randomlyiii/Project_CAN-BusEdgeCollector/demo-phase2/can总线故障恢复-从站续发+主从站心跳状态恢复.jpg

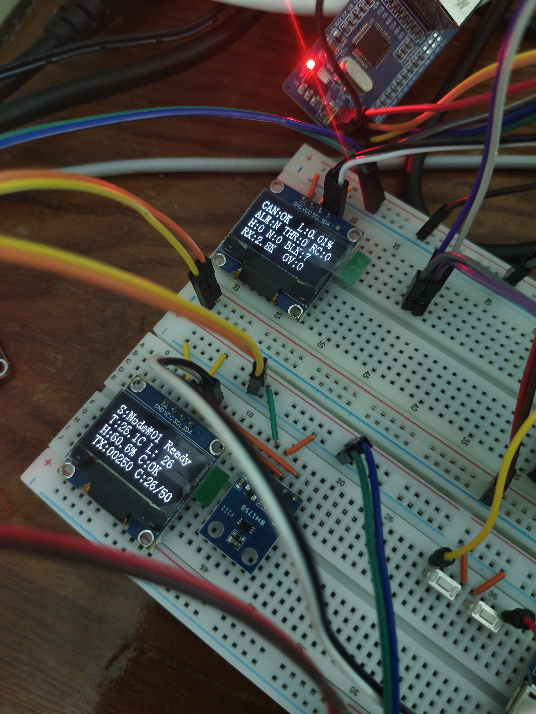
demo-phase2/can总线故障恢复-从站续发+主从站心跳状态恢复.jpg
