randomlyiii/Project_CAN-BusEdgeCollector/demo-phase1/从站故障报警接触-oled第四行显示OK.jpg

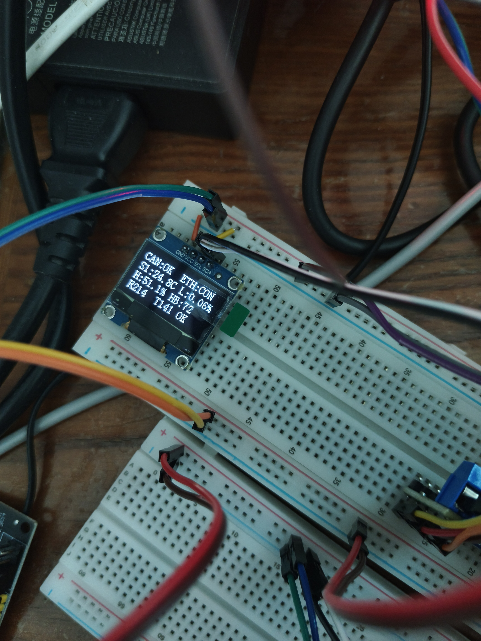
demo-phase1/从站故障报警接触-oled第四行显示OK.jpg
