randomlyiii/Project_CAN-BusEdgeCollector/排线设计/阶段三排线设计.md

# 阶段三（最终阶段）排线设计

> 架构变更：从站由**单硬件配置**升级为**单代码仓双变体**架构 —— 修改 `Config/slave_config.h` 一行宏即可在两种从站硬件之间切换，无需改动任何源码。
>
> 主站硬件与阶段一/二完全相同，无任何变更。

---

## 一、双从站变体总览

| 固件变体 | 配置宏 | 传感器组合 | 面包板 | 用途 |
|---|---|---|---|---|
| **从站 1** | `SLAVE_NODE_01` | DHT11（温湿度）+ BH1750（光照） | 面包板 #2 | 环境监测节点 |
| **从站 2** | `SLAVE_NODE_02` | LM393（光敏 DO/AO）+ 预留通道 CH1 | 面包板 #2 | 光敏监测 + 扩展占位 |

> **切换方式**：编辑 `Config/slave_config.h` 第 23 行，将 `SLAVE_NODE_VARIANT` 改为 `SLAVE_NODE_01` 或 `SLAVE_NODE_02`，重新编译即可。同一块 STM32 板子，换传感器 + 换宏 = 换身份。

---

## 二、系统整体接线拓扑

```
                    PC (上位机)
              Modbus TCP / ST-Link
                        │
                   ┌────┴────┐
                   │ 以太网   │ ST-Link
                   │ (RJ45)   │ (SWD)
                   │          │
┌──────────────────┴──────────┴───────────────┐
│             主站 (面包板 #1)                  │
│  ┌───────────────────────────────────────┐   │
│  │ STM32F103C8T6        W5500 以太网     │   │
│  │ OLED(0x78)           TJA1050 CAN      │   │
│  │ [SWD 4P排针]                          │   │
│  └───────────────────────────────────────┘   │
└──────────────────────┬──────────────────────┘
                        │ CAN_H / CAN_L / GND (杜邦线)
┌───────────────────────┴──────────────────────┐
│             从站 (面包板 #2)                   │
│                                               │
│  ┌─ 变体 A: Node#01 (SLAVE_NODE_01) ──────┐  │
│  │ STM32  DHT11(PB11)  BH1750(PB8/PB9)   │  │
│  │ OLED(PB8/PB9) ← 与BH1750共享I2C!       │  │
│  │ KEY1(PA0)  KEY2(PA1)  TJA1050 CAN     │  │
│  └────────────────────────────────────────┘  │
│                   或                          │
│  ┌─ 变体 B: Node#02 (SLAVE_NODE_02) ──────┐  │
│  │ STM32  LM393(PB0/PB1)  OLED(PB8/PB9)   │  │
│  │ DHT11(PB11)  KEY1(PA0)  KEY2(PA1)      │  │
│  │ TJA1050 CAN   预留 CH1 (软件占位)       │  │
│  └────────────────────────────────────────┘  │
│                                               │
│  [SWD 4P排针]                                 │
└───────────────────────────────────────────────┘
```

---

## 三、主站 (Master) 接线

> **与阶段一/二完全一致，无任何变更。** 主站固件也未修改。

### 3.1 引脚分配表

| STM32引脚 | 连接目标 | 说明 |
|---|---|---|
| PC15 | W5500 RST | 以太网复位 |
| PA4 | W5500 SCS | SPI 片选 |
| PA5 | W5500 SCLK | SPI 时钟 |
| PA6 | W5500 MISO | SPI 主入从出 |
| PA7 | W5500 MOSI | SPI 主出从入 |
| PA11 | TJA1050 RXD | CAN RX |
| PA12 | TJA1050 TXD | CAN TX |
| PB8 | OLED SCL | 软件 I2C 时钟 |
| PB9 | OLED SDA | 软件 I2C 数据 |

### 3.2 OLED

```
OLED (0.96寸, I2C, 4pin)
  GND → GND
  VCC → 3.3V
  SCL → PB8
  SDA → PB9
```

### 3.3 TJA1050 CAN 收发器

```
TJA1050 模块
  VCC  → 5V      (板子5V排针或外接电源)
  GND  → GND
  TXD  → PA12
  RXD  → PA11
  CANH → CAN_H 总线 (杜邦线→从站)
  CANL → CAN_L 总线 (杜邦线→从站)
```

### 3.4 W5500 以太网模块

```
W5500 模块
  GND  → GND   ← 模块有两个GND引脚，都要接地！
  GND  → GND   ← (第2个GND)
  3.3V → 3.3V  ← 外接独立3.3V，不要从STM32 3.3V排针取电
  SCLK → PA5
  MISO → PA6
  MOSI → PA7
  SCS  → PA4
  RST  → PC15
  INT  → 不接 (轮询模式)
  RJ45 → 网线 → PC
```

### 3.5 ST-Link

```
ST-Link           蓝 Pill SWD 排针
  SWDIO  →    SWDIO
  SWCLK  →    SWCLK
  GND    →    GND
  3.3V   →    不接！(板子USB供电，接3.3V会导致电源对顶)
```

---

## 四、从站变体 A — Node#01（DHT11 + BH1750）

> **配置宏**：`slave_config.h` → `SLAVE_NODE_VARIANT   SLAVE_NODE_01`
>
> **节点身份**：CAN ID=0x01, OLED 显示 "Node#01"

### 4.1 引脚分配表

| STM32引脚 | 连接目标 | 功能 | 备注 |
|---|---|---|---|
| PA0 | KEY1（故障上报） | GPIO 输入，内部上拉 | — |
| PA1 | KEY2（故障恢复） | GPIO 输入，内部上拉 | — |
| PA11 | TJA1050 RXD | CAN RX | — |
| PA12 | TJA1050 TXD | CAN TX | — |
| PB8 | OLED SCL + **BH1750 SCL** | **共享 I2C 时钟** | ★ 一总线两设备 |
| PB9 | OLED SDA + **BH1750 SDA** | **共享 I2C 数据** | ★ 一总线两设备 |
| PB11 | DHT11 DATA | 单总线 | — |

### 4.2 BH1750 光照传感器 ★ 重新引入

> BH1750 在阶段一曾规划但未实现，阶段二被 LM393 替代，最终阶段作为从站 1 的标准传感器重新引入。

```
BH1750 模块 (5pin)
  VCC  → 3.3V
  GND  → GND
  SCL  → PB8  ← 与 OLED SCL 共用！
  SDA  → PB9  ← 与 OLED SDA 共用！
  ADDR → GND  (地址引脚接地 → 7-bit 地址 0x23)
```

#### ⚠️ I2C 总线共享注意事项

BH1750 与 OLED **共用 PB8/PB9 I2C 总线**，两者通过不同设备地址区分：

| 设备 | I2C 地址 | 说明 |
|---|---|---|
| OLED | 0x78 (7-bit) | 写地址 0x78 |
| BH1750 | 0x23 (7-bit) | 写地址 0x46，读地址 0x47 |

> **软件 I2C 驱动**（`bh150.c/h`）使用 GPIO 模拟 I2C 时序（非 STM32 硬件 I2C 外设），因此不存在总线仲裁冲突。但两设备**不可在同一时刻被不同任务访问** —— 本项目设计中 BH1750 读取在 `vTask_Sensor`（优先级 3），OLED 刷新在 `vTask_Housekeep`（优先级 0），FreeRTOS 抢占式调度自然串行化访问。
>
> **如果将来传感器采集频率提高或驱动改为 DMA 模式，需加互斥锁保护 PB8/PB9。**

### 4.3 DHT11 温湿度

```
DHT11 (3pin)
  VCC  → 3.3V
  DATA → PB11 (需 4.7kΩ 上拉，模块已内置则免)
  GND  → GND
```

### 4.4 按键

```
KEY1: 一端→PA0, 另一端→GND
KEY2: 一端→PA1, 另一端→GND
(PA0/PA1 内部上拉，按下=低电平)
```

### 4.5 TJA1050 CAN 收发器

```
TJA1050 模块
  VCC  → 5V
  GND  → GND
  TXD  → PA12
  RXD  → PA11
  CANH → CAN_H 总线
  CANL → CAN_L 总线
```

### 4.6 ST-Link

```
ST-Link           蓝 Pill SWD 排针
  SWDIO  →    SWDIO
  SWCLK  →    SWCLK
  GND    →    GND
  3.3V   →    不接！
```

### 4.7 OLED 显示效果（Node#01）

```
┌──────────────────┐
│S:Node#01 Ready   │  ← Line 1: 节点身份 + 全局状态
│T:25.3C H:62.1%   │  ← Line 2: DHT11 温湿度 (SENSOR_TYPE_DHT11)
│Lux: 610          │  ← Line 3: BH1750 光照 (SENSOR_TYPE_BH1750)
│TX:00036 C:00/50  │  ← Line 4: CAN TX 计数 + 缓存占用
└──────────────────┘
```

### 4.8 从站 1 引脚总览

```
         ┌──────────────────────────┐
         │     STM32F103C8T6        │
         │                          │
  PB11 ←─→┤ DHT11 DATA             │
  PB8  ──→┤ OLED SCL + BH1750 SCL  │  ← 共享 I2C
  PB9  ←─→┤ OLED SDA + BH1750 SDA  │  ← 共享 I2C
  PA0  ←──┤ KEY1                   │
  PA1  ←──┤ KEY2                   │
  PA11 ←──┤ TJA1050 RXD            │
  PA12 ──→┤ TJA1050 TXD            │
         │                          │
         │  PA9  → USART1 TX (调试) │
         │  PA10 ← USART1 RX (调试) │
         └──────────────────────────┘
```

---

## 五、从站变体 B — Node#02（LM393 + 预留通道）

> **配置宏**：`slave_config.h` → `SLAVE_NODE_VARIANT   SLAVE_NODE_02`
>
> **节点身份**：CAN ID=0x02, CAN ID offset=0x10, OLED 显示 "Node#02"

### 5.1 引脚分配表

| STM32引脚 | 连接目标 | 功能 | 备注 |
|---|---|---|---|
| PA0 | KEY1（故障上报） | GPIO 输入，内部上拉 | — |
| PA1 | KEY2（故障恢复） | GPIO 输入，内部上拉 | — |
| PA11 | TJA1050 RXD | CAN RX | — |
| PA12 | TJA1050 TXD | CAN TX | — |
| PB0 | **LM393 DO** | GPIO 输入（数字亮/暗） | ★ |
| PB1 | **LM393 AO** | ADC1_IN9（模拟光照值） | ★ |
| PB8 | OLED SCL | 软件 I2C 时钟 | — |
| PB9 | OLED SDA | 软件 I2C 数据 | — |
| PB11 | DHT11 DATA | 单总线 | 保留接线，固件不编译 |

> **DHT11 保留接线**：虽然 Node#02 固件中 `slave_has_dht11=0`（DHT11 驱动不参与编译），但硬件保留 PB11→DHT11 接线，方便将来切换回 Node#01 验证而无须重新接线。

### 5.2 光敏电阻模块（LM393）

常见 4pin 光敏电阻模块，采用 **LM393 双路比较器**，板载光敏电阻（GL55系列）+ 可调电位器：

```
光敏模块 (4pin)
  VCC → 3.3V
  GND → GND
  DO  → PB0   ← 数字输出（超过阈值=LOW, 低于=HIGH，电位器可调）
  AO  → PB1   ← 模拟输出（0~3.3V，光越强电压越高）
```

#### 模块工作原理

```
         VCC (3.3V)
           │
          ┌┴┐
          │ │  光敏电阻 (GL55: 亮=5~10kΩ, 暗=0.5~1MΩ)
          │ │
          └┬┘
           ├──→ AO (分压点，光越强→阻值越小→电压越高)
           │
          ┌┴┐
          │ │  固定电阻 (10kΩ)
          │ │
          └┬┘
           │
          GND

  AO ──→ LM393 同相输入(+)
         反相输入(-) ← 电位器分压 (阈值电压)
         LM393 输出 → DO (开漏，需上拉)
```

- **光强 ↑** → 光敏电阻值 ↓ → AO 电压 ↑ → ADC 读值 ↑
- **AO 电压 > 阈值** → DO = LOW (亮灯)，反之 DO = HIGH (暗灯)
- DO 为 **开漏输出**，PB0 配置为 **内部上拉（IPU）**，无需外接电阻

#### 电位器调节

| 方向 | 效果 |
|---|---|
| 顺时针拧 | 阈值电压升高 → DO 更难触发 LOW → 需要更大光强 |
| 逆时针拧 | 阈值电压降低 → DO 更容易触发 LOW → 较小光强即触发 |

> 调试建议：在正常室内光照下，缓慢逆时针拧电位器直到 DO LED 刚好熄灭，此时为临界阈值。再逆时针拧 1/8 圈，确保正常光照下 DO=LOW（亮）。

#### 驱动 API（lm393.c / lm393.h）

```c
void     Lm393_Init(void);        // 初始化 PB0(IPU) + PB1(AIN) + ADC1
uint8_t  Lm393_ReadDigital(void); // 读 DO → 0=亮, 1=暗
uint16_t Lm393_ReadAnalog(void);  // 读 AO → ADC 原始值 0~4095
```

### 5.3 预留通道 CH1

Node#02 包含一个**软件层面的预留通道**，目前仅占位：

| 占位项 | 内容 | 说明 |
|---|---|---|
| 传感器表条目 | `sensor_t { .name="CH1", .init_fn=NULL, .read_fn=NULL }` | 占位，不执行任何驱动 |
| CAN 功能码 | `CAN_FUNC_RESERVED (0x07)` | 预留 CAN 通讯点位 |
| sensor_data_t | `reserved.ch1 (uint16_t)` | 预留 2 字节数据字段 |
| OLED 行 | `CH1:----` | 占位显示行 |

后续扩展步骤（接入 4-20mA / 开关量 / 继电器等新传感器）：
1. 编写传感器驱动（`my_sensor.h/c`）
2. 在 `sensor_manager.c` 中编写适配器函数
3. 替换 `#if slave_has_reserved` 代码块中 `NULL` 为适配器函数指针
4. 更新 `main.c` OLED 渲染 `case SENSOR_TYPE_RESERVED` 为实际数据显示
5. **无需修改任何任务代码或 CAN 通信逻辑**

### 5.4 按键（同 Node#01）

```
KEY1: 一端→PA0, 另一端→GND
KEY2: 一端→PA1, 另一端→GND
```

### 5.5 OLED 显示效果（Node#02）

```
┌──────────────────┐
│S:Node#02 Ready   │  ← Line 1: 节点身份 + 全局状态
│Lm DO:BR A:1234   │  ← Line 2: LM393 数字+模拟 (SENSOR_TYPE_LM393_AO)
│CH1:----          │  ← Line 3: 预留通道占位 (SENSOR_TYPE_RESERVED)
│TX:00042 C:00/50  │  ← Line 4: CAN TX 计数 + 缓存占用
└──────────────────┘
```

> DO 显示：`BR` = Bright（亮，低于阈值），`DK` = Dark（暗，高于阈值）

### 5.6 从站 2 引脚总览

```
         ┌──────────────────────────┐
         │     STM32F103C8T6        │
         │                          │
  PB0  ←──┤ LM393 DO               │
  PB1  ←──┤ LM393 AO (ADC1_IN9)    │
  PB8  ──→┤ OLED SCL               │
  PB9  ←─→┤ OLED SDA               │
  PB11 ←─→┤ DHT11 DATA (保留接线)   │  ← 固件不编译，硬件不动
  PA0  ←──┤ KEY1                   │
  PA1  ←──┤ KEY2                   │
  PA11 ←──┤ TJA1050 RXD            │
  PA12 ──→┤ TJA1050 TXD            │
         │                          │
         │  PA9  → USART1 TX (调试) │
         │  PA10 ← USART1 RX (调试) │
         └──────────────────────────┘
```

---

## 六、双变体切换对照

| 维度 | Node#01 (SLAVE_NODE_01) | Node#02 (SLAVE_NODE_02) |
|---|---|---|
| **切换方式** | `#define SLAVE_NODE_VARIANT SLAVE_NODE_01` | `#define SLAVE_NODE_VARIANT SLAVE_NODE_02` |
| **CAN 节点 ID** | 0x01 | 0x02 |
| **CAN ID offset** | 0x00 | 0x10 |
| **传感器** | DHT11 + BH1750 | LM393 + 预留 CH1 |
| **传感器个数** | 2（OLED 行 2/3 均有数据） | 2（一行 LM393 + 一行占位） |
| **I2C 设备** | OLED(0x78) + BH1750(0x23) 共享 PB8/PB9 | OLED(0x78) 独占 PB8/PB9 |
| **ADC 使用** | 无 | ADC1_IN9 (PB1) |
| **唯一 GPIO** | 仅 PB11 (DHT11) | PB0/PB1 (LM393) |
| **编译驱动** | dht11.c + bh150.c | lm393.c |
| **排除驱动** | lm393.c | dht11.c + bh150.c |

---

## 七、CAN 总线（不变）

```
主站 CAN_H ──── 杜邦线 ──── 从站 CAN_H
主站 CAN_L ──── 杜邦线 ──── 从站 CAN_L
主站 GND   ──── 杜邦线 ──── 从站 GND   (共地必须！)
```

- 桌面短距离（<30cm）：不接终端电阻
- 长距离：需 120Ω 1/4W 终端电阻
- CAN 差分总线也必须共地（TJA1050 共模电压以本地 GND 为参考）

---

## 八、供电（不变）

```
外接 5V/3.3V 电源
  5V  → 主站 5V 排针  → TJA1050 VCC
       → 从站 5V 排针  → TJA1050 VCC
  3.3V → 主站 3.3V 排针 → OLED / W5500
       → 从站 3.3V 排针 → OLED / DHT11 / BH1750或LM393
  GND  → 主站 GND / 从站 GND
```

或每块蓝 Pill 单独 USB 供电（桌面调试推荐）。

---

## 九、面包板布局

```
面包板#1 (主站)                   面包板#2 (从站)
┌──────────────────────┐        ┌──────────────────────────────┐
│ STM32       W5500    │        │ STM32       DHT11           │
│ OLED        TJA1050  │        │ OLED        [BH1750或LM393] │  ← 变体切换
│ [SWD排针]            │        │ KEY1/2      TJA1050         │
│                      │        │ [SWD排针]                    │
└──────────────────────┘        └──────────────────────────────┘

面包板#3 (备用 — 用于 Node#02 同时保留 Node#01 接线时)
```

> **变体切换物理操作**：
> - Node#01 → Node#02：拔掉 BH1750 模块（PB8/PB9），插上 LM393 模块（PB0/PB1/3.3V/GND），改 `slave_config.h` 宏，重新编译烧录
> - Node#02 → Node#01：拔掉 LM393 模块，插上 BH1750 模块，改宏，重新编译烧录
>
> PB11→DHT11 接线两变体通用，无需插拔。

---

## 十、检查清单

### 10.1 通用检查项（两变体共用）

| # | 检查项 | ✓ |
|---|---|---|
| 1 | 主站 OLED：PB8→SCL, PB9→SDA, VCC→3.3V, GND→GND | ☐ |
| 2 | 主站 TJA1050：PA11→RXD, PA12→TXD, VCC→5V, GND→GND | ☐ |
| 3 | 主站 W5500：PA5→SCLK, PA6→MISO, PA7→MOSI, PA4→SCS, PC15→RST, **双GND都接地**, 外接3.3V供电 | ☐ |
| 4 | 主站 ST-Link：SWDIO/SWCLK/GND（不接3.3V） | ☐ |
| 5 | 从站 OLED：PB8→SCL, PB9→SDA, VCC→3.3V, GND→GND | ☐ |
| 6 | 从站 TJA1050：PA11→RXD, PA12→TXD, VCC→5V, GND→GND | ☐ |
| 7 | 从站 DHT11：PB11→DATA, VCC→3.3V, GND→GND | ☐ |
| 8 | 从站按键：PA0→KEY1→GND, PA1→KEY2→GND | ☐ |
| 9 | 从站 ST-Link：SWDIO/SWCLK/GND（不接3.3V） | ☐ |
| 10 | CAN 总线：CAN_H 互连, CAN_L 互连, GND 互连 | ☐ |
| 11 | 供电：5V 给 TJA1050, 3.3V 给 OLED/W5500/DHT11/传感器 | ☐ |
| 12 | 网线：主站 W5500 RJ45 → PC | ☐ |
| 13 | 配置宏：`slave_config.h` 中 `SLAVE_NODE_VARIANT` 与实际接线匹配 | ☐ |

### 10.2 Node#01 专项检查项

| # | 检查项 | ✓ |
|---|---|---|
| N1-1 | BH1750 模块：VCC→3.3V, GND→GND, SCL→PB8, SDA→PB9, ADDR→GND | ☐ |
| N1-2 | BH1750 与 OLED 共用 PB8/PB9，确认无短路 | ☐ |
| N1-3 | OLED 显示验证：Line2="T:xx.xC H:xx.x%", Line3="Lux:xxxx" | ☐ |
| N1-4 | 手遮 BH1750 → Lux 值下降；手电筒照射 → Lux 值上升 | ☐ |
| N1-5 | 编译时 `slave_has_dht11=1`, `slave_has_bh1750=1`, `slave_has_lm393=0` | ☐ |

### 10.3 Node#02 专项检查项

| # | 检查项 | ✓ |
|---|---|---|
| N2-1 | LM393 模块：VCC→3.3V, GND→GND, DO→PB0, AO→PB1 | ☐ |
| N2-2 | LM393 与 OLED 独立走线，不共用 I2C 总线 | ☐ |
| N2-3 | 电位器调试：正常光照下 DO LED 刚好熄灭 → 临界阈值 | ☐ |
| N2-4 | OLED 显示验证：Line2="Lm DO:BR A:xxxx", Line3="CH1:----" | ☐ |
| N2-5 | 手遮光敏电阻 → Lm AO 值降、DO 变 DK；手电筒照射 → AO 值升、DO 变 BR | ☐ |
| N2-6 | 编译时 `slave_has_dht11=0`, `slave_has_lm393=1`, `slave_has_reserved=1` | ☐ |
| N2-7 | 预留通道占位正确：OLED 第三行显示 `CH1:----`，主站可收到 CAN_FUNC_RESERVED 帧 | ☐ |

---

## 十一、架构迁移对照

```
阶段一（裸机）                阶段二（FreeRTOS）              最终阶段（双变体）
──────────────────────────────────────────────────────────────────────────────
1个从站                     1个从站                        1套源码 → 2种从站
DHT11 单传感器              DHT11 + LM393                 Node#01: DHT11+BH1750
无 FreeRTOS                 FreeRTOS 4任务                 Node#02: LM393+预留
SLAVE_NODE_ID 硬编码        SLAVE_NODE_ID 硬编码           slave_node_id 配置宏驱动
CAN_SendTempHumi()          CAN_SendTempHumi/Light()      CAN_SendSensorData(type_id)
OLED 简单3行                OLED 4行 条件判断             OLED 4行 表驱动自适应
单文件 main.c               main.c + CAN_User.c            + Config/ + sensor_manager
传感器全局变量分散           传感器全局变量集中             传感器数据→sensor_t.last_data
```

---

## 十二、相关文档

| 文档 | 路径 | 说明 |
|---|---|---|
| 最终阶段设计 | `phase_md/最终阶段.md` | 架构升级完整设计文档 |
| README | `README.md` | 项目总体设计（CAN 协议 / 双FIFO / 采集分层） |
| 阶段一排线 | `排线设计/阶段一排线设计.md` | 主站引脚 / CAN / 供电基础 |
| 阶段二排线 | `排线设计/阶段二排线设计.md` | LM393 光敏模块详细说明 |
| LM393 驱动 | `CanEdgeGateWay_Slave/Hardware/lm393.c` | 光敏 DO/AO 驱动源码 |
| BH1750 驱动 | `CanEdgeGateWay_Slave/Hardware/bh150.c` | 光照传感器 I2C 驱动源码 |
| 传感器管理 | `CanEdgeGateWay_Slave/Hardware/sensor_manager.c` | 表驱动适配器层 |
| 配置入口 | `CanEdgeGateWay_Slave/Config/slave_config.h` | 变体切换宏 |
