randomlyiii/Project_CAN-BusEdgeCollector/CanEdgeGateWay_Slave/README.txt

1. 在./Config/slave config.h进行从站之间的烧录切换
2.在./Config/slave_node_0x.h改传感器报警阈值
