randomlyiii/Project_CAN-BusEdgeCollector/demo-phase3/readme.txt

项目设计要求功能均已开发实现；本次验收仅完成核心功能测试，全量边界验证待持续拷机完善。
