randomlyiii/Project_CAN-BusEdgeCollector/phase_md/阶段二遇到的问题及解决.md

# 阶段二遇到的问题及解决

> 时间段: 2026-07-24  
> 主题: FreeRTOS 内核编译/链接错误修复 + RAM 布局优化 + 阶段二-2 恢复 W5500/CAN 调试

---

## 问题一: TCB_t 缺少 ulNotifiedValue[] / ucNotifyState[] (30 errors)

**错误信息**:
```
FreeRTOS\src\tasks.c(405): error: #136: struct "tskTaskControlBlock" has no field "ulNotifiedValue"
FreeRTOS\src\tasks.c(406): error: #136: struct "tskTaskControlBlock" has no field "ucNotifyState"
... (共 30 个 error，遍布 tasks.c 405~1270 行)
```

**根因**:

`task.h` 中 TCB_t 有两个定义:
1. **顶部无守卫** (第39行): 简化版 TCB，只含 8 个字段，并设置了 `#define tskTCB_DEFINED`
2. **MPU 守卫内** (第192行): 完整 TCB，含通知/Mutex/统计字段，受 `#ifndef tskTCB_DEFINED` 保护

`tasks.c` 虽然正确定义了 `MPU_WRAPPERS_INCLUDED_FROM_API_FILE`，但顶部简化版先执行了 `#define tskTCB_DEFINED`，导致 `#ifndef tskTCB_DEFINED` 为假，完整 TCB 被跳过。通知字段 `ulNotifiedValue[]` 和 `ucNotifyState[]` 只存在于完整 TCB 中 (`configUSE_TASK_NOTIFICATIONS == 1`)，因此全部报错。

**修复** (task.h, Master + Slave):
1. 将顶部简化版 TCB + `#define tskTCB_DEFINED` 替换为前向声明: `typedef struct tskTaskControlBlock TCB_t;`
2. 移除 MPU 区域内的 `#ifndef tskTCB_DEFINED` / `#define tskTCB_DEFINED` / `#endif` 三重守卫
3. 结果: 外部代码只看到前向声明（只能声明指针），内核代码定义 MPU 宏后看到完整结构体

**涉及文件**:
- `CanEdgeGateWay_Master/FreeRTOS/inc/task.h`
- `CanEdgeGateWay_Slave/FreeRTOS/inc/task.h`

---

## 问题二: QueueDefinition 缺少 ucQueueTypeInternal (5 errors)

**错误信息**:
```
FreeRTOS\src\queue.c(113): error: #136: struct "QueueDefinition" has no field "ucQueueTypeInternal"
... (共 5 个 error，遍布 queue.c 113~1070 行)
```

**根因**:
`queue.h` 中 `QueueDefinition` 结构体缺少 `ucQueueTypeInternal` 字段。此字段用于区分普通队列/互斥锁/递归互斥锁/信号量——`queue.c` 在多处使用它判断队列类型。

**修复** (queue.h, Master + Slave):
在 `QueueDefinition` 末尾、`};` 之前添加:
```c
uint8_t ucQueueTypeInternal;
```

**涉及文件**:
- `CanEdgeGateWay_Master/FreeRTOS/inc/queue.h`
- `CanEdgeGateWay_Slave/FreeRTOS/inc/queue.h`

---

## 问题三: port.c 汇编符号未定义 (3 errors)

**错误信息**:
```
FreeRTOS\src\port.c(48): error: A1516E: Bad symbol 'pxCurrentTCB', not defined or external
FreeRTOS\src\port.c(68): error: A1516E: Bad symbol 'pxCurrentTCB', not defined or external
FreeRTOS\src\port.c(78): error: A1516E: Bad symbol 'vTaskSwitchContext', not defined or external
```

**根因**:
ARMCC v5 的 `__asm` 函数由 **armasm** 汇编器独立处理，不继承 C 级别的 `extern` 声明。即使用 C 写了 `extern TCB_t * volatile pxCurrentTCB;` 和 `extern void vTaskSwitchContext(void);`，汇编器仍然不知道这些符号。必须用 `IMPORT` 指令显式声明。

**修复** (port.c, Master + Slave):

`vPortSVCHandler` — 添加 IMPORT:
```asm
__asm void vPortSVCHandler(void)
{
    PRESERVE8
    IMPORT pxCurrentTCB          ← 新增
    ldr r3, =pxCurrentTCB
    ...
```

`xPortPendSVHandler` — 添加 IMPORT:
```asm
__asm void xPortPendSVHandler(void)
{
    PRESERVE8
    IMPORT pxCurrentTCB          ← 新增
    IMPORT vTaskSwitchContext    ← 新增
    mrs r0, psp
    ...
```

**涉及文件**:
- `CanEdgeGateWay_Master/FreeRTOS/src/port.c`
- `CanEdgeGateWay_Slave/FreeRTOS/src/port.c`

---

## 问题四: SysTick_Handler 重复定义 (1 error)

**错误信息**:
```
.\Objects\ceg_master.axf: Error: L6200E: Symbol SysTick_Handler multiply defined (by port.o and delay.o).
```

**根因**:
`FreeRTOSConfig.h` 中有宏 `#define xPortSysTickHandler SysTick_Handler`，把 `port.c` 的 `xPortSysTickHandler` 重命名为 `SysTick_Handler`。同时 `System/Delay.c` 也定义了 `void SysTick_Handler(void)`（作为向量表入口，桥接到 FreeRTOS）。两个 .o 都导出了 `SysTick_Handler`，链接冲突。

SVC 和 PendSV 直接用宏映射没问题（因为没有用户代码定义这些 handler），但 SysTick 的中转模式需要 Delay.c 持有向量表入口。

**修复** (FreeRTOSConfig.h, Master + Slave):
移除 `#define xPortSysTickHandler SysTick_Handler`，保留 SVC/PendSV 映射不变。

修复后的调用链:
```
向量表 → Delay.c:SysTick_Handler() → port.c:xPortSysTickHandler() → FreeRTOS tick
```

**涉及文件**:
- `CanEdgeGateWay_Master/User/FreeRTOSConfig.h`
- `CanEdgeGateWay_Slave/User/FreeRTOSConfig.h`

---

## 问题五: TCB_t 缺少 uxStackDepth (1 error)

**错误信息**:
```
FreeRTOS\src\tasks.c(1040): error: #136: struct "tskTaskControlBlock" has no field "uxStackDepth"
```

**根因**:
之前的"简化版"TCB 有 `configSTACK_DEPTH_TYPE uxStackDepth` 字段，但 MPU 守卫内的完整 TCB 漏掉了。`tasks.c` 的 `uxTaskGetStackHighWaterMark()` 使用此字段做边界检查。

**修复** (task.h, Master + Slave):
在 MPU TCB_t 的 `pcTaskName` 之后添加:
```c
configSTACK_DEPTH_TYPE  uxStackDepth;
```

> 注意: 标准 FreeRTOS 的 TCB_t 没有此字段——这是本项目添加的非标准字段。

---

## 问题六: 链接时 RAM 溢出 (20 errors)

**错误信息**:
```
.\Objects\ceg_master.axf: Error: L6406E: No space in execution regions with .ANY selector matching startup_stm32f10x_md.o(STACK).
.\Objects\ceg_master.axf: Error: L6406E: No space in execution regions with .ANY selector matching tasks.o(.bss).
... (共 20 个 error)
.\Objects\ceg_master.axf: Error: L6407E: Sections of aggregate size 0xa30 bytes could not fit into .ANY selector(s).
```

**根因**:
STM32F103C8T6 总共只有 **20KB RAM**。内存占用分析:

| 项目 | 修改前 | 占比 |
|---|---|---|
| MSP 栈 | 1KB | 5% |
| 系统堆 (libc) | 0.5KB | 2.5% |
| FreeRTOS 堆 (ucHeap[]) | **15KB** | **75%** |
| 固定占用合计 | 16.5KB | 82.5% |
| 剩余给 .data/.bss | 3.5KB | 17.5% |

实际 .data/.bss 需要 ~6.1KB (3.5KB + 溢出 2.6KB)，超过了剩余的 3.5KB。FreeRTOS 堆的 `ucHeap[]` 是静态数组，编译时计入 .bss，15KB 占掉了 75% 的 RAM。

**修复** (三处):

| 参数 | 修改前 | 修改后 | 释放 |
|---|---|---|---|
| `configTOTAL_HEAP_SIZE` | 15KB | **10KB** | 5KB |
| `Stack_Size` (MSP) | 1024B | **512B** | 512B |
| `Heap_Size` (libc) | 512B | **0** | 512B |
| **合计释放** | — | — | **6KB** |

其中 libc 堆归零是安全的——项目只使用 FreeRTOS 的 `pvPortMalloc`，不调用标准 `malloc()`。

**涉及文件**:
- `CanEdgeGateWay_Master/User/FreeRTOSConfig.h` (configTOTAL_HEAP_SIZE)
- `CanEdgeGateWay_Slave/User/FreeRTOSConfig.h` (configTOTAL_HEAP_SIZE)
- `CanEdgeGateWay_Master/Start/startup_stm32f10x_md.s` (Stack_Size, Heap_Size)

---

## 问题七: xTaskGetCurrentTaskHandle 未定义 (1 error)

**错误信息**:
```
.\Objects\ceg_master.axf: Error: L6218E: Undefined symbol xTaskGetCurrentTaskHandle (referred from tasks.o).
```

**根因**:
`task.h` 中声明了 `TaskHandle_t xTaskGetCurrentTaskHandle(void)`，`tasks.c` 中互斥锁代码调用了它（用于判断当前任务是否持有互斥锁），但 **从未实现**这个函数。

**修复** (tasks.c, Master + Slave):
在 `uxTaskGetNumberOfTasks()` 之后添加:
```c
TaskHandle_t xTaskGetCurrentTaskHandle(void)
{
    TaskHandle_t xReturn;
    taskENTER_CRITICAL();
    {
        xReturn = (TaskHandle_t)pxCurrentTCB;
    }
    taskEXIT_CRITICAL();
    return xReturn;
}
```

**涉及文件**:
- `CanEdgeGateWay_Master/FreeRTOS/src/tasks.c`
- `CanEdgeGateWay_Slave/FreeRTOS/src/tasks.c`

---

## 总结

| 问题编号 | 错误数 | 类型 | 涉及文件 | 根因类别 |
|---|---|---|---|---|
| 一 | 30 | 编译 | task.h | TCB_t 守卫宏逻辑错误 |
| 二 | 5 | 编译 | queue.h | 结构体缺少字段 |
| 三 | 3 | 编译 | port.c | ARMCC 汇编 IMPORT 缺失 |
| 四 | 1 | 链接 | FreeRTOSConfig.h | 宏重命名与显式定义冲突 |
| 五 | 1 | 编译 | task.h | MPU TCB 遗漏非标准字段 |
| 六 | 20 | 链接 | FreeRTOSConfig.h + startup | RAM 预算超限 |
| 七 | 1 | 链接 | tasks.c | 函数只声明未实现 |
| **合计** | **61** | — | **6 类文件** | — |

**修改文件清单** (共 11 个文件, Master + Slave 对称):

```
CanEdgeGateWay_Master/FreeRTOS/inc/task.h         ← 问题一、五
CanEdgeGateWay_Master/FreeRTOS/inc/queue.h        ← 问题二
CanEdgeGateWay_Master/FreeRTOS/src/port.c          ← 问题三
CanEdgeGateWay_Master/FreeRTOS/src/tasks.c         ← 问题七
CanEdgeGateWay_Master/User/FreeRTOSConfig.h        ← 问题四、六
CanEdgeGateWay_Master/Start/startup_stm32f10x_md.s ← 问题六
CanEdgeGateWay_Slave/...(同上 6 个文件)              ← 对称修复
```

**获得的经验**:
1. 不标准的 FreeRTOS 内核文件需要从标准版分叉时，要理解每个 `#ifdef` 守卫的意图
2. ARMCC v5 的 `__asm` 和 GCC inline asm 机制完全不同，移植时 `IMPORT`/`EXPORT` 是关键
3. STM32F103C8 的 20KB RAM 很紧张，`configTOTAL_HEAP_SIZE` 是第一个要审查的配置
4. 链接错误比编译错误更难排查——用"RAM 预算表"逐项检查是最快的方法

---

## 问题八: MSP 栈溢出 → 卡 "M: Starting..."（IWDG 循环复位）

**时间段**: 2026-07-24 下午（阶段二-2：恢复 W5500/CAN）

**症状**:
```
OLED 显示:
  Line 1: M: Starting...
  Line 2: FreeRTOS v10.4
  （此后无变化，约 1-2 秒后系统复位，循环）
```

**根因**:
MSP 栈（主栈，Main Stack Pointer）仅 512 字节（`0x200`）。`CAN_User_Init()` + `W5500_Init()` 的调用链深度超过 512B 时，MSP 溢出向下踩踏 `.bss` 段中的 `ucHeap[]`（FreeRTOS 堆数组），导致：
1. `pvPortMalloc()` 返回损坏的内存块
2. `xTaskCreate()` 创建的 TCB 或栈被破坏
3. 调度器启动后首个被破坏的任务运行 → 硬 fault 或死循环
4. IWDG 无法喂狗 → 1 秒后系统复位 → 重复循环

**为什么之前 3 调试任务能跑**：
调试版不调 `CAN_User_Init` 和 `W5500_Init`，MSP 调用链浅，512B 勉强够。

**修复** (`startup_stm32f10x_md.s`, Master + Slave):
```asm
Stack_Size      EQU     0x00000400    ; 512B → 1024B
```

**涉及文件**:
- `CanEdgeGateWay_Master/Start/startup_stm32f10x_md.s`
- `CanEdgeGateWay_Slave/Start/startup_stm32f10x_md.s`

**教训**:
- MSP 栈溢出是最隐蔽的故障模式之一——它踩的是 `ucHeap[]`，不是栈自身，所以不会触发 HardFault，而是表现为随机任务崩溃
- 添加重量级初始化函数（CAN_Init、SPI 外设探测）前必须评估 MSP 需求
- 文档 §10.3 已提前警告 512B 不够，恢复 W5500/CAN 后果然触发

---

## 问题九: CAN_User_Init 中断使能顺序错误

**时间段**: 2026-07-24 下午

**症状**:
潜在——CAN 错误 ISR 在信号量尚未创建时触发 → `xSemaphoreGiveFromISR(NULL)` → `configASSERT` → 死循环。

**根因**:
`CAN_User_Init()` 中中断使能和信号量创建顺序反了：

```c
// 错误顺序:
CAN_ITConfig(CAN1, CAN_IT_ERR, ENABLE);   // ← 先使能中断
CAN_NVIC_Init();                             // ← 在 NVIC 层也使能
g_can_monitor_sem = xSemaphoreCreateBinary(); // ← 后创建信号量
```

若 CAN 外设在 init 后立即因总线噪声/ACK 错误触发 `CAN1_SCE_IRQHandler`，此时 `g_can_monitor_sem` 为 NULL，`xSemaphoreGiveFromISR(NULL)` 触发 `configASSERT` → 关中断 + 死循环。

**修复** (CAN_User.c, Master + Slave):
```c
// 正确顺序: 先创建所有内核对象
g_can_rx_sem         = xSemaphoreCreateBinary();
g_can_fifo_not_empty = xSemaphoreCreateBinary();
g_can_monitor_sem    = xSemaphoreCreateBinary();
FIFO_Init();             // 创建 mutex

// 再使能中断
CAN_ITConfig(CAN1, CAN_IT_FMP0, ENABLE);
CAN_ITConfig(CAN1, CAN_IT_ERR, ENABLE);
CAN_ITConfig(CAN1, CAN_IT_BOF, ENABLE);
CAN_NVIC_Init();
```

**涉及文件**:
- `CanEdgeGateWay_Master/Hardware/CAN_User.c`
- `CanEdgeGateWay_Slave/Hardware/CAN_User.c`

---

## 问题十: Task_W5500 临界区阻塞 SysTick → 任务饿死

**时间段**: 2026-07-24 下午

**症状**:
`Task_W5500` 用 `taskENTER_CRITICAL()` 包裹 `W5500_TCPServer_Run()`，导致 SysTick 中断被屏蔽，Tick 计数不增长，其他任务因 `vTaskDelayUntil` 无法到期而饿死。IWDG 在 1 秒后复位系统。

**根因**:
- `taskENTER_CRITICAL()` 设置 `BASEPRI = 0x50`
- SysTick 优先级 15，NVIC 寄存器值 `0xF0`，满足 `0xF0 ≥ 0x50` → **被屏蔽**
- 同时 PendSV（优先级 15 = `0xF0`）也被屏蔽 → 无法上下文切换
- `W5500_TCPServer_Run` 内部 `SocketCmd` 超时循环用 `Delay_us(DWT)` 消耗真实时间（200ms/次），但不产生任何 Tick
- 退出临界区后 Tick 追赶式增长，但 Housekeep 的 `vTaskDelayUntil(1000ms)` 实际上隔了数秒才到期
- 期间 IWDG 已超时复位

**修复**：
W5500 独占 SPI1（OLED 是软件 I2C，CAN 是 bxCAN），无需临界区保护。移除 `taskENTER_CRITICAL/taskEXIT_CRITICAL`：

```c
for (;;) {
    W5500_TCPServer_Run();    // 无临界区
    ModbusTCP_Process();      // 无临界区
    vTaskDelay(pdMS_TO_TICKS(5));
}
```

**涉及文件**:
- `CanEdgeGateWay_Master/User/main.c`

**经验**:
- BASEPRI 不是 PRIMASK！`taskENTER_CRITICAL()` 只屏蔽优先级 ≥ 阈值的中断。SysTick 和 PendSV 通常设为最低优先级（15），恰好被 BASEPRI 挡住。
- 一个任务在临界区里吃 DWT 延时 = 整个系统停摆（比 `vTaskDelay` 更恶劣，因为 Tick 不前进）。
- 临界区的正确使用场景：多个任务共享同一外设（如 SPI Flash）。单任务独占的外设不需要临界区。

---

## 问题十一: Task_Housekeep 栈不足

**时间段**: 2026-07-24 下午

**症状**:
`Task_Housekeep`（栈 256 words）调用 `OLED_UpdateDisplay()` 时栈溢出，破坏堆中相邻的其他任务栈 → 系统异常。

**根因**:
`OLED_UpdateDisplay()` 内部多次调用 `sprintf()`（ARMCC 标准库实现，栈消耗极大）。文档 §11 已明确要求：**调用 sprintf 的任务至少分配 384 words**。

**修复** (main.c):
```c
#define STACK_HOUSEKEEP     384    // 256 → 384
```

**涉及文件**:
- `CanEdgeGateWay_Master/User/main.c`

---

## 总结（第二阶段完整版）

| 问题编号 | 错误数 | 类型 | 涉及文件 | 根因类别 |
|---|---|---|---|---|
| 一 | 30 | 编译 | task.h | TCB_t 守卫宏逻辑错误 |
| 二 | 5 | 编译 | queue.h | 结构体缺少字段 |
| 三 | 3 | 编译 | port.c | ARMCC 汇编 IMPORT 缺失 |
| 四 | 1 | 链接 | FreeRTOSConfig.h | 宏重命名与显式定义冲突 |
| 五 | 1 | 编译 | task.h | MPU TCB 遗漏非标准字段 |
| 六 | 20 | 链接 | FreeRTOSConfig.h + startup | RAM 预算超限 |
| 七 | 1 | 链接 | tasks.c | 函数只声明未实现 |
| **八** | **运行时** | **启动** | **startup_stm32f10x_md.s** | **MSP 栈溢出踩 ucHeap[]** |
| **九** | **运行时** | **中断** | **CAN_User.c** | **ISR 信号量竞态** |
| **十** | **运行时** | **调度** | **main.c** | **临界区锁死 SysTick** |
| **十一** | **运行时** | **栈** | **main.c** | **Task_Housekeep 栈不足** |

**阶段二最终修改文件清单**（共 15 个文件）：

```
编译/链接修复（问题一~七，11 文件）:
  FreeRTOS/inc/task.h
  FreeRTOS/inc/queue.h
  FreeRTOS/src/port.c
  FreeRTOS/src/tasks.c
  User/FreeRTOSConfig.h
  Start/startup_stm32f10x_md.s
  （Master + Slave 各 6 个 = 12 个实例文件，其中 startup 共用改动）

运行期修复（问题八~十一，本日新增）:
  Start/startup_stm32f10x_md.s             ← MSP 512→1024
  Hardware/CAN_User.c                      ← 中断使能顺序
  User/main.c                              ← 移除 W5500 临界区 + Housekeep 栈增大
  （Master + Slave 各 1 个 startup + 1 个 CAN_User = 4 文件）
```

---

## 问题十二: CAN_ProcessFrame 在任务上下文调用 xSemaphoreGiveFromISR

**时间段**: 2026-07-24 傍晚（阶段二-2 深度排查）

**症状**:
调度器启动后系统卡 "M: Starting..."，无 HardFault、无 STACK OVERFLOW 提示。所有 init 通过，xTaskCreate 全部成功，但调度器启动后立即挂死。

**根因**:
`CAN_ProcessFrame()` 由 `Task_CAN_Rx`（任务上下文，prio 5）调用，但内部使用了 `xSemaphoreGiveFromISR()`：

```c
// CAN_User.c — CAN_ProcessFrame (called from Task_CAN_Rx)
static BaseType_t tx_woken = pdFALSE;
xSemaphoreGiveFromISR(g_can_fifo_not_empty, &tx_woken);  // ← 致命错误
xSemaphoreGive(g_can_fifo_not_empty);                     // ← 还重复给了两次
```

`xSemaphoreGiveFromISR` 内部调用 `xQueueGiveFromISR`，该函数会:
1. 调用 `xTaskRemoveFromEventList()` — 操作调度器的 `xPendingReadyList`
2. 修改就绪优先级位图 `uxReadyPriorities`
3. 这些操作必须与 `xTaskIncrementTick()`（在 SysTick 中运行）互斥

在 ISR 上下文中，互斥由中断优先级保证（BASEPRI 挡不住优先级 0-4 的 ISR，但 FromISR 函数内部有 `portASSERT_IF_INTERRUPT_PRIORITY_INVALID` 检查——前提是 `configASSERT_DEFINED=1`）。

在任务上下文中**没有任何保护**——`xTaskRemoveFromEventList` 和 `xTaskIncrementTick` 同时修改同一组链表，造成**链表指针损坏**。

损坏后的就绪列表在下一次 PendSV 上下文切换时遍历到野指针 → 系统挂死在 `vTaskSwitchContext` 中。

**为什么调试版不触发**：调试版没有创建 `Task_CAN_Rx`（`#if 0` 包裹），`CAN_ProcessFrame` 从未被调用。

**修复** (CAN_User.c):
```c
// 删除:
static BaseType_t tx_woken = pdFALSE;
xSemaphoreGiveFromISR(g_can_fifo_not_empty, &tx_woken);
xSemaphoreGive(g_can_fifo_not_empty);

// 替换为:
xSemaphoreGive(g_can_fifo_not_empty);
```

**涉及文件**:
- `CanEdgeGateWay_Master/Hardware/CAN_User.c`

---

## 问题十三: 多任务抢占 SPI 总线（无声数据竞争）

**时间段**: 2026-07-24 傍晚

**症状**:
`ETH_StateStr()`（由 `Task_Housekeep` prio 0 调用）直接调 `W5500_LinkUp()` = `R_Common(REG_PHYCFGR)` = SPI 读。当 `Task_W5500`（prio 1）在 SPI 操作中被 SysTick 打断后恢复时，Housekeep 可能正好在中间操作 SPI1 寄存器。

**根因**:
两个不同优先级的任务通过不同代码路径共享 SPI1：

| 任务 | 优先级 | 如何访问 SPI |
|---|---|---|
| `Task_W5500` | 1 | 主循环 `W5500_TCPServer_Run()` |
| `Task_Housekeep` | 0 | `OLED_UpdateDisplay()` → `ETH_StateStr()` → `W5500_LinkUp()` |

SPI1 外设只有一组寄存器。两个任务在不同优先级上操作同一组寄存器，任何交叉访问都会破坏对方的传输。

**为什么临界区不能解决这个问题？** 因为 `taskENTER_CRITICAL` 会锁死 SysTick（§15）。正确的做法是用互斥锁或将 SPI 访问集中于一个任务。

**修复** (W5500.h/c, main.c):
W5500 任务将 `g_phy_linked`（PHY 链接状态）每 5ms 缓存一次。其他任务通过 `W5500_IsLinkUpCached()` 读取缓存，不触 SPI：

```c
// W5500.c — 在 W5500_TCPServer_Run 中更新
g_phy_linked = W5500_LinkUp();   // SPI 操作只在 W5500 任务中

// W5500.h — 对外暴露无 SPI 的缓存读取
uint8_t W5500_IsLinkUpCached(void) { return g_phy_linked; }

// main.c — OLED 用缓存
if (!W5500_IsLinkUpCached()) return "NOLK";
```

**涉及文件**:
- `CanEdgeGateWay_Master/Hardware/W5500.h`
- `CanEdgeGateWay_Master/Hardware/W5500.c`
- `CanEdgeGateWay_Master/User/main.c`

---

## 问题十四: 调度器启动前 ISR 已置位信号量

**时间段**: 2026-07-24 傍晚

**症状**:
CAN 错误 ISR 在 `vTaskStartScheduler()` 之前触发，将 `g_can_monitor_sem` 置位。调度器启动后 PendSV 立即切换到 `Task_CAN_Monitor`（prio 4），在 Idle 任务上下文尚未完全建立时运行——虽然不会立即崩溃，但可能干扰优先级就绪队列的初始状态。

**根因**:
`CAN_User_Init` 在 `main()` 中被调用，ISR 在 `vTaskStartScheduler()` 之前即可触发。即使信号量在 ISR 之前已创建（问题九已修复），ISR 的 Give 操作会将信号量置位。调度器启动时，等待该信号量的任务立即就绪。

**修复** (main.c):
在 `vTaskStartScheduler()` 之前 Drain 所有信号量：
```c
{
    BaseType_t sem;
    do { sem = xSemaphoreTake(g_can_monitor_sem, 0); } while (sem == pdPASS);
    do { sem = xSemaphoreTake(g_can_rx_sem, 0); } while (sem == pdPASS);
    do { sem = xSemaphoreTake(g_can_fifo_not_empty, 0); } while (sem == pdPASS);
}
```

**涉及文件**:
- `CanEdgeGateWay_Master/User/main.c`

---

## 总结（阶段二最终版）

| 问题编号 | 类型 | 涉及文件 | 根因类别 |
|---|---|---|---|
| 一~七 | 编译/链接 | 6 类内核文件 | FreeRTOS 内核文件不完整 |
| 八 | 运行时-启动 | startup | MSP 栈溢出踩堆 |
| 九 | 运行时-中断 | CAN_User.c | 使能顺序错误 |
| 十 | 运行时-调度 | main.c | 临界区锁 SysTick |
| 十一 | 运行时-栈 | main.c | Task_Housekeep 栈不足 |
| **十二** | **运行时-内核** | **CAN_User.c** | **FromISR 在任务上下文调用** |
| **十三** | **运行时-外设** | **W5500.h/c, main.c** | **多任务抢占 SPI** |
| **十四** | **运行时-初始化** | **main.c** | **预启动 ISR 置位信号量** |

**阶段二最终修改文件清单**（共 18 个文件）：

```
编译/链接修复（问题一~七，12 文件）:
  FreeRTOS/inc/task.h, queue.h, port.c, tasks.c
  User/FreeRTOSConfig.h
  Start/startup_stm32f10x_md.s
  （Master + Slave 各 6 个 = 12 个实例文件）

运行期修复（问题八~十四，本日新增 6 文件）:
  Start/startup_stm32f10x_md.s              ← MSP 512→1024
  Hardware/CAN_User.c                       ← 中断顺序 + FromISR 误用 + FIFO_Init 顺序
  Hardware/W5500.h / W5500.c                ← 添加 W5500_IsLinkUpCached()
  User/main.c                               ← 移除临界区 + Housekeep 栈 + xTaskCreate 检查 + 信号量 Drain
  （Master + Slave 各 1 个 startup + 1 个 CAN_User = 4 个额外文件）
```

**核心教训**:
1. MSP 栈溢出无 HardFault——它踩的是堆，不是栈边界
2. BASEPRI 临界区 ≠ 关所有中断——SysTick 和 PendSV 恰好被 BASEPRI 挡在外面
3. 中断使能前必须确保所有 ISR 使用的内核对象已创建——否则 NULL 触发 assert
4. ARMCC 的 `sprintf` 栈消耗极大——256 words 不够，至少 384 words
5. **`xSemaphoreGiveFromISR` 的名字就是字面意思——只能在 ISR 上下文用。在任务上下文调用它会破坏调度器链表，造成看似完全无关的挂死**
6. **SPI 外设应当只有一个"所有者"任务。其他任务需要状态时，通过缓存读取，不直接操作 SPI**
7. **调度器启动前的 ISR 可能已置位信号量。启动前 Drain 一次是安全的防御性编程**
8. 渐进式验证的价值：3 调试任务 → 6 真实任务过程中暴露了 7 个独立运行期问题

---

## 2026-07-25~28 新增关键问题

以下问题在后续调试中逐步发现并修复。

## 问题十五: CAN_SendFrame timeout 下溢 (uint32_t 0→0xFFFFFFFF)

**根因**: uint32_t timeout 自减到 0 后下溢为 0xFFFFFFFF，if (timeout == 0) 永远为假，超时后仍返回成功。

**修复**: 改为 while (timeout--) { if (Ok) goto send_ok; } 结构。

**涉及文件**: Master/Slave CAN_User.c

## 问题十六: Delay_GetTick 返回 tick 非 ms (Master 时间放大 10x)

**根因**: Delay_GetTick() = xTaskGetTickCount()。Master 100Hz tick=10ms，所有 *_MS 常量实际 10 倍。

**修复**: 改为 xTaskGetTickCount() * portTICK_PERIOD_MS。

**涉及文件**: Master/Slave System/Delay.c

## 问题十七: 总线负载显示 0.00% (低速时窗口无帧)

**根因**: SLAVE ~4.5帧/秒，大多数 100ms 窗口 0 帧，负载归零。

**修复**: 加入 g_last_bus_activity 时间戳，窗口内无帧但 1s 内有活动时最小显示 0.01%。

**涉及文件**: Master CAN_User.c

## 问题十八: CAN 线断开后主站仍显示 CAN:OK

**根因**: error_level 始终 0; 节点需心跳超时(原 15s); last_heartbeat_tick=0 不触发。

**修复**: 加入启动 3s 无帧判 WRN; 离线检测用 last_heartbeat_tick(离线不清零)。

**涉及文件**: Master main.c

## 问题十九: Slave 离线缓存后不自动重连

**根因**: can_offline=1 时 SendCANData 直接缓存返回, 永不试发。

**修复**: 移除 can_offline 提前返回, 一律试发失败才缓存。

**涉及文件**: Slave CAN_User.c

## 问题二十: 最终稳定架构

### Master — 2 任务
| 任务 | 优先级 | 栈 | 周期 |
|---|:-----:|:--:|:---:|
| Task_Unified | 1 | 768w | 10ms |
| Task_Housekeep | 0 | 384w | 1s |

### Slave — 4 任务
| 任务 | 优先级 | 栈 | 周期 |
|---|:-----:|:--:|:---:|
| Task_Sensor | 3 | 384w | 2s |
| Task_CAN_Slave | 2 | 320w | 500ms |
| Task_Key | 1 | 192w | 20ms |
| Task_Housekeep | 0 | 384w | 1s |

### 关键配置
CAN 500kbps, PA11=IPU, AWUM/ABOM=DISABLE, ISR prio 5/6
IWDG Prescaler=128 Reload=1250
Master 100Hz, Slave 1000Hz

### 最终核心教训
9. uint32_t 自减到 0 后下溢为 0xFFFFFFFF — if (timeout == 0) 永远不成立
10. Delay_GetTick 应返回 ms 而非 tick — Master 100Hz 下时间放大 10x
11. TJA1050 浮空时 RX 误报 ACK — 不依赖 CAN_TransmitStatus 判离线
12. can_offline 提前返回阻止重连 — 必须能试发
13. heartbeat_count 被清零 — 离线检测用 last_heartbeat_tick
14. 低速时多数窗口 0 帧 — 用最近活动时间戳兜底 0.01%
15. 启动 3 秒无帧判 WRN — 覆盖 CAN 线从未接通
