randomlyiii/Project_CAN-BusEdgeCollector/demo-phase1/modbuspoll.png

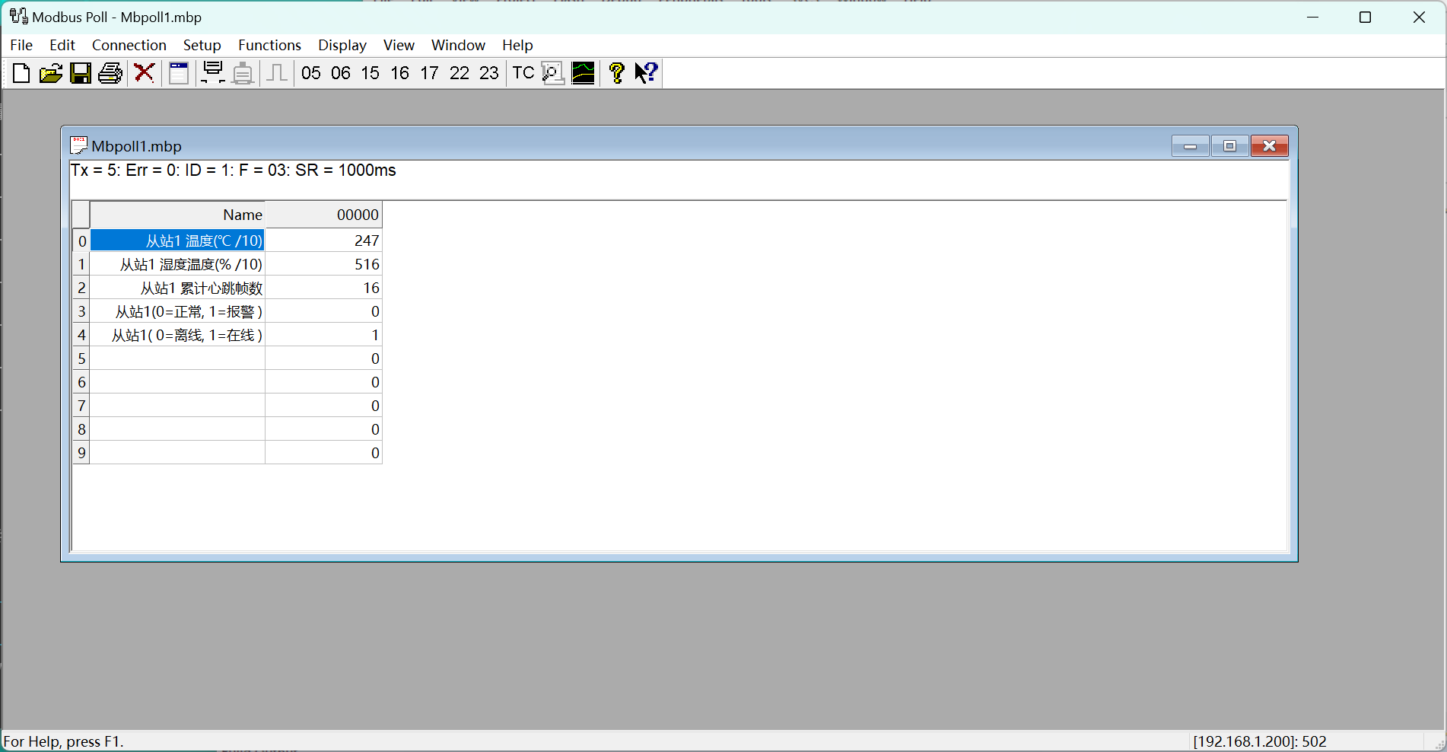
demo-phase1/modbuspoll.png
