randomlyiii/Project_CAN-BusEdgeCollector/demo-phase1/主从站全景.jpg

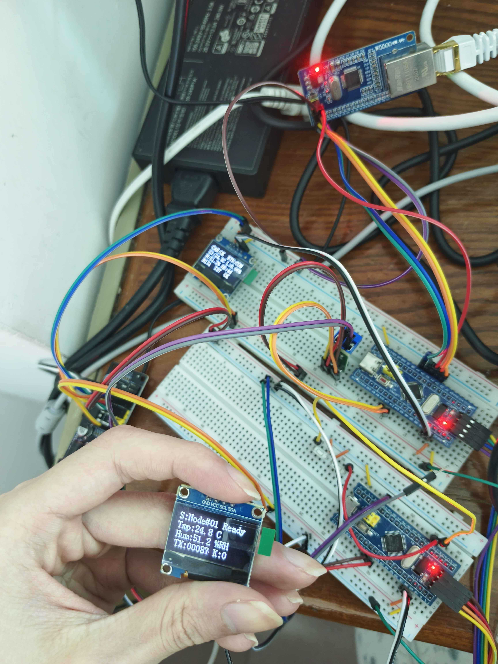
demo-phase1/主从站全景.jpg
