randomlyiii/Project_CAN-BusEdgeCollector/demo-phase1/主从站正常运行.jpg

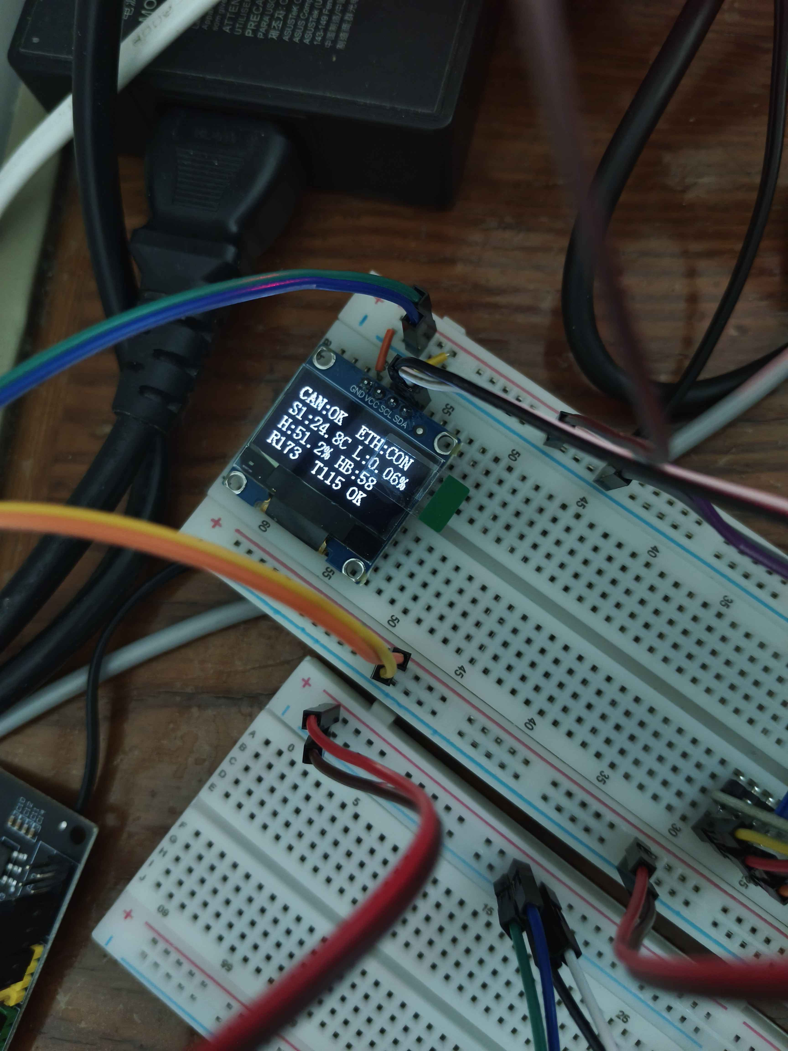
demo-phase1/主从站正常运行.jpg
