randomlyiii/Project_CAN-BusEdgeCollector/demo-phase2/modbuspoll-从站报警.png

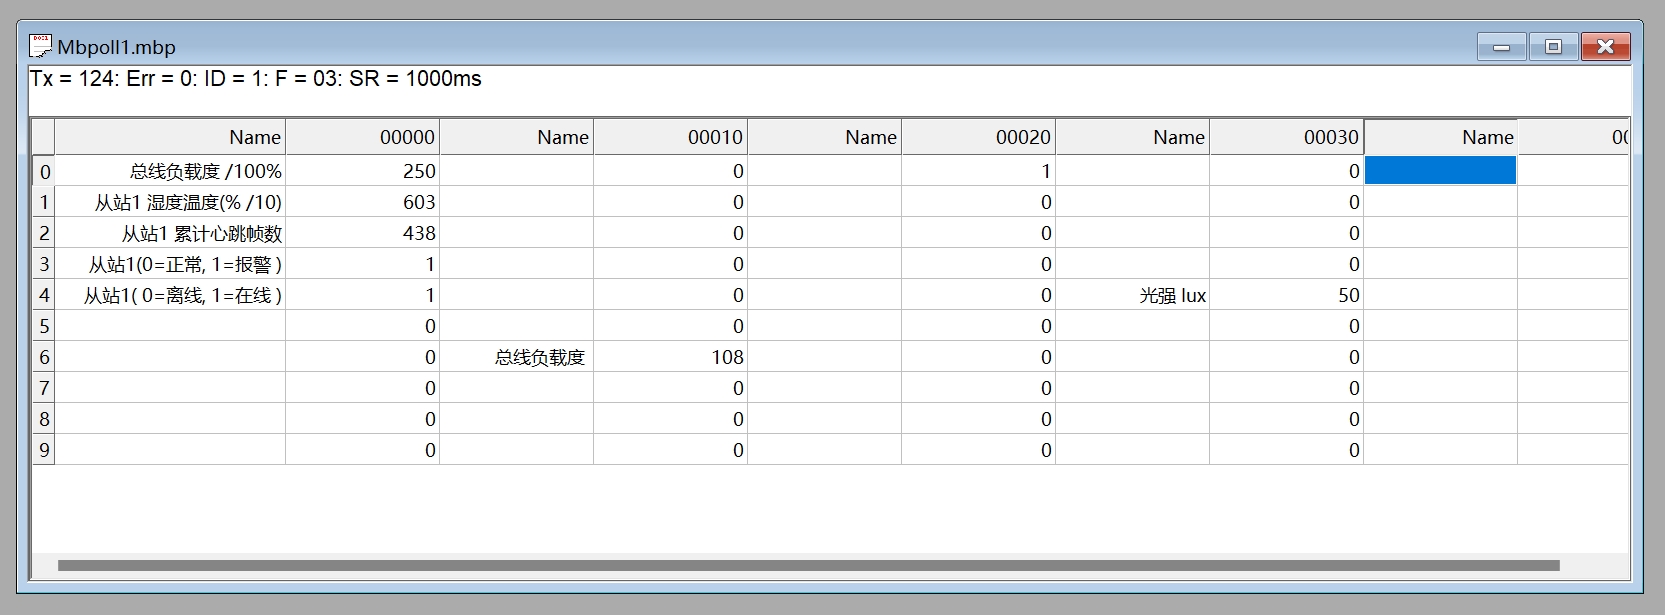
demo-phase2/modbuspoll-从站报警.png
