randomlyiii/Project_CAN-BusEdgeCollector/demo-phase2/modbuspoll-从站报警恢复.png

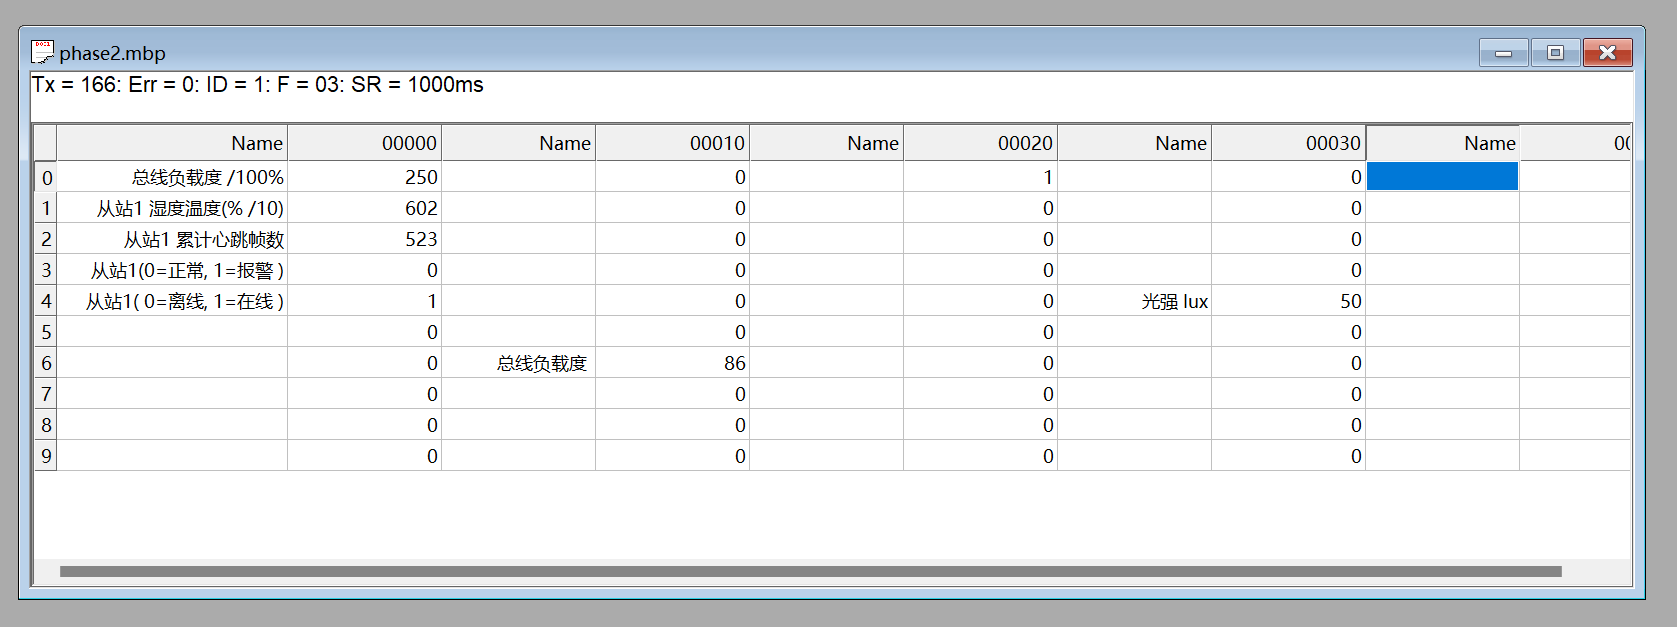
demo-phase2/modbuspoll-从站报警恢复.png
