randomlyiii/Project_CAN-BusEdgeCollector/demo-phase2/modbuspoll.png

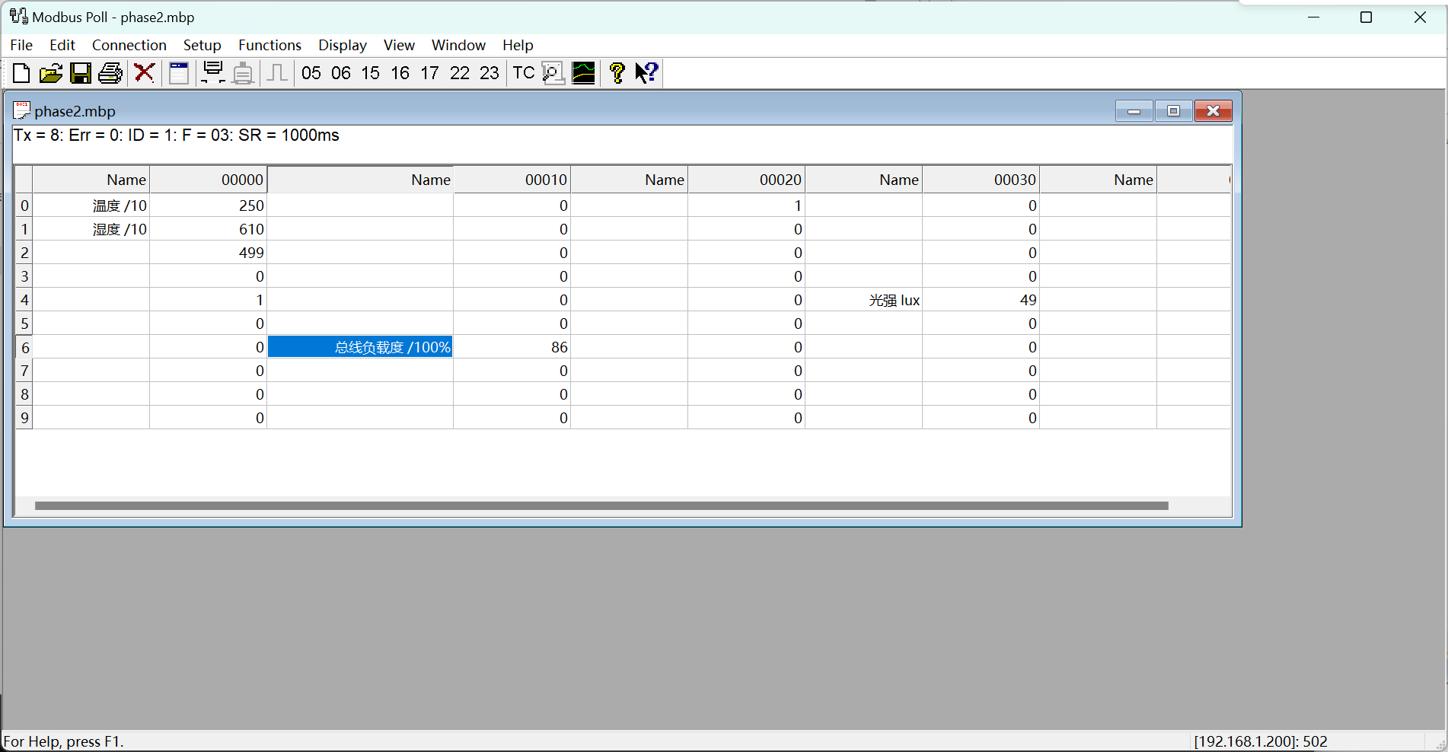
demo-phase2/modbuspoll.png
