randomlyiii/Project_CAN-BusEdgeCollector/demo-phase2/主站page1-传感器数据.jpg

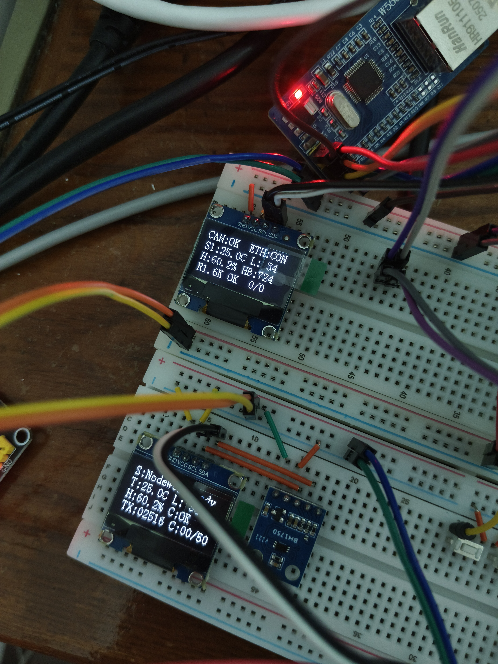
demo-phase2/主站page1-传感器数据.jpg
