randomlyiii/Project_CAN-BusEdgeCollector/demo-phase2/主站page2-can总线数据.jpg

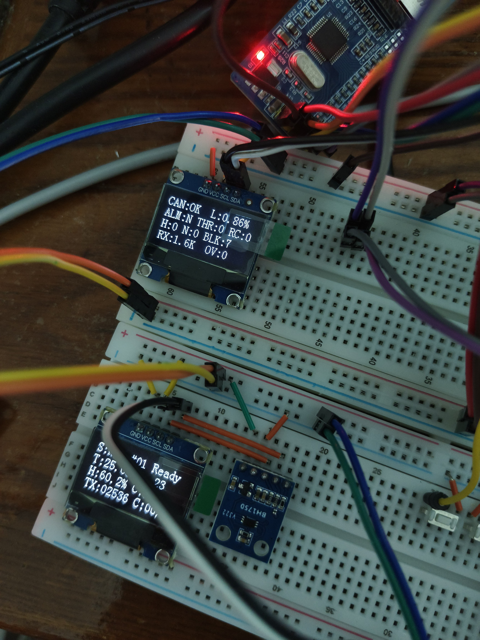
demo-phase2/主站page2-can总线数据.jpg
