randomlyiii/Project_CAN-BusEdgeCollector/demo-phase2/代码改动自动触发看门狗重启成功.jpg

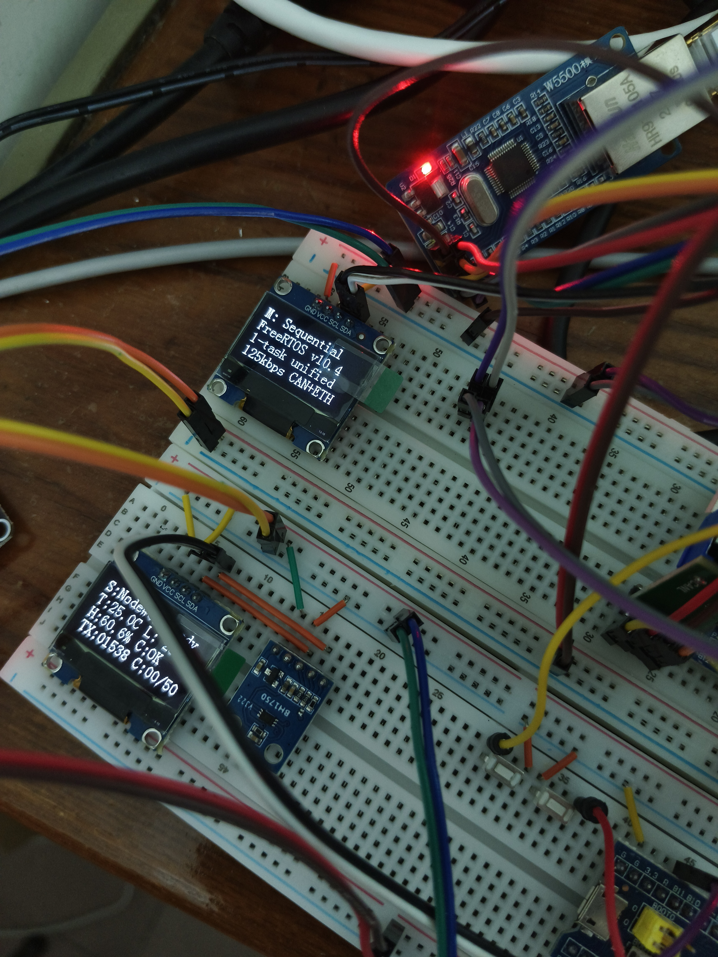
demo-phase2/代码改动自动触发看门狗重启成功.jpg
