randomlyiii/Project_CAN-BusEdgeCollector/demo-phase3/modbuspoll-上位机监控.png

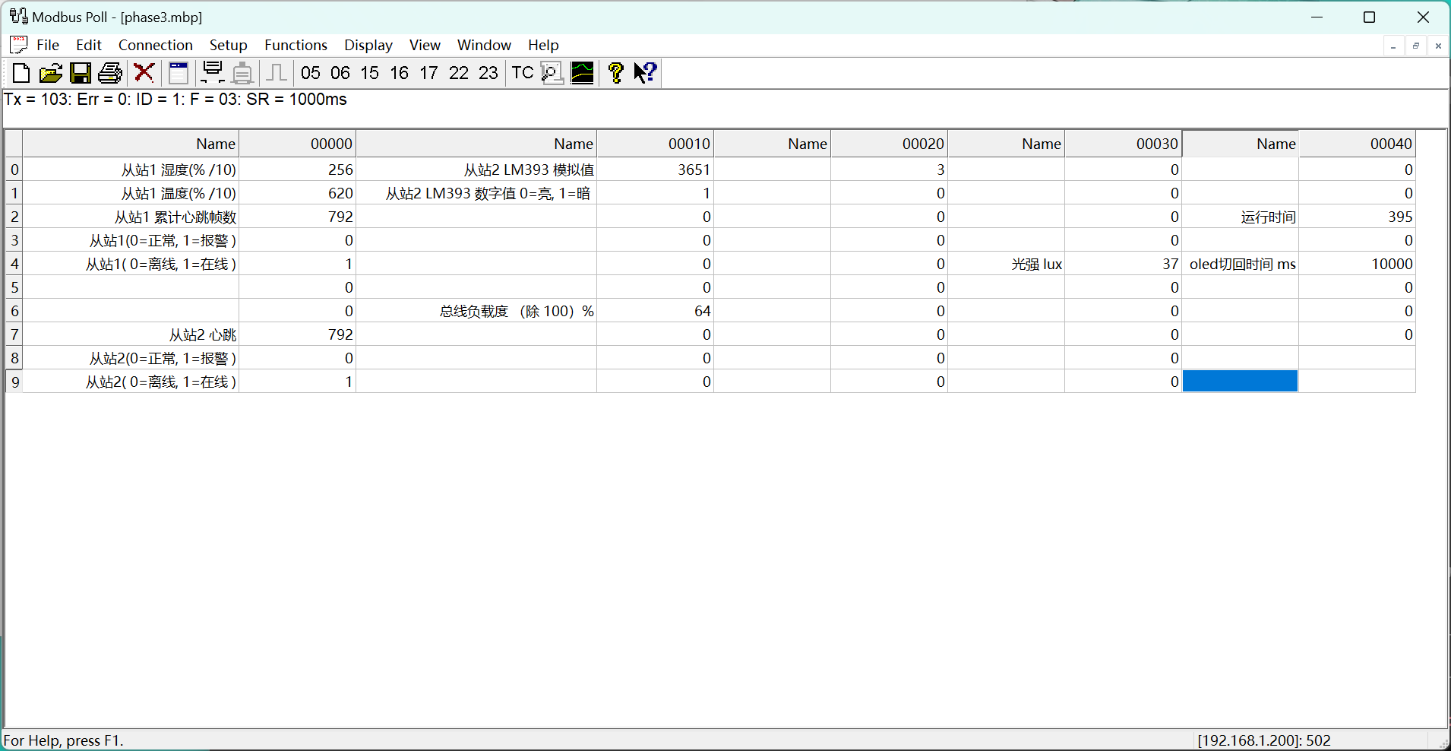
demo-phase3/modbuspoll-上位机监控.png
