randomlyiii/Project_CAN-BusEdgeCollector/demo-phase3/主站检测-alm-从站1传感器超限报警.jpg

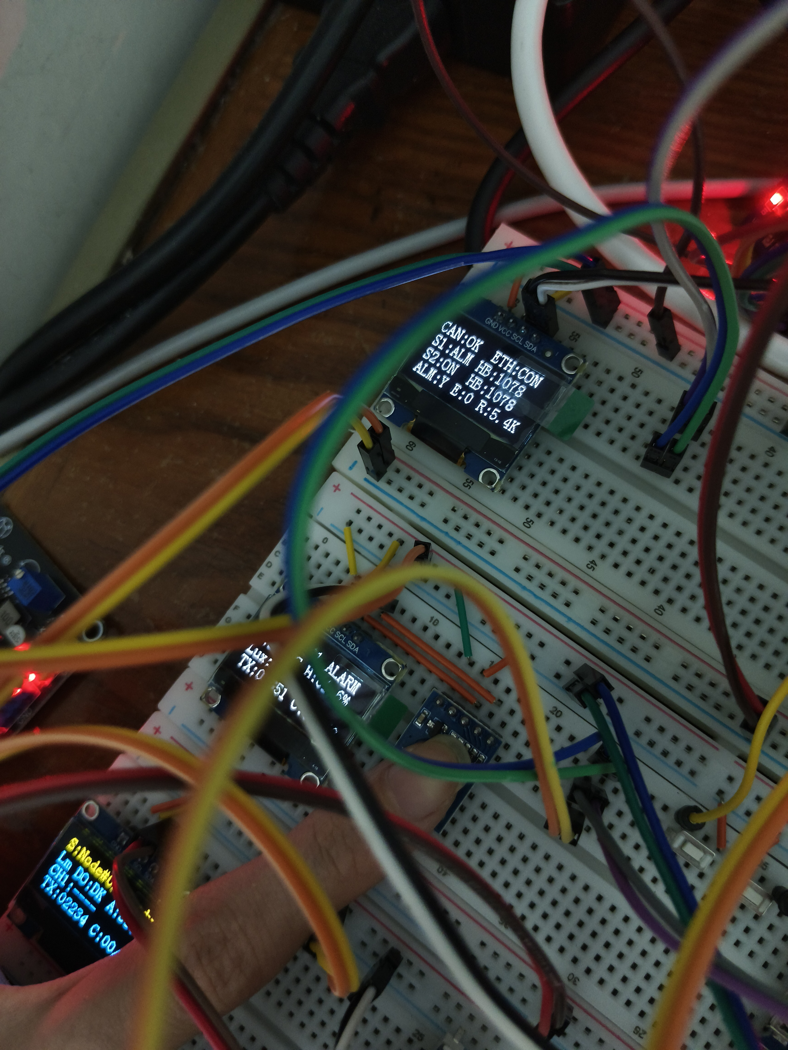
demo-phase3/主站检测-alm-从站1传感器超限报警.jpg
