randomlyiii/Project_CAN-BusEdgeCollector/demo-phase3/主站检测-alm-从站2传感器掉线.jpg

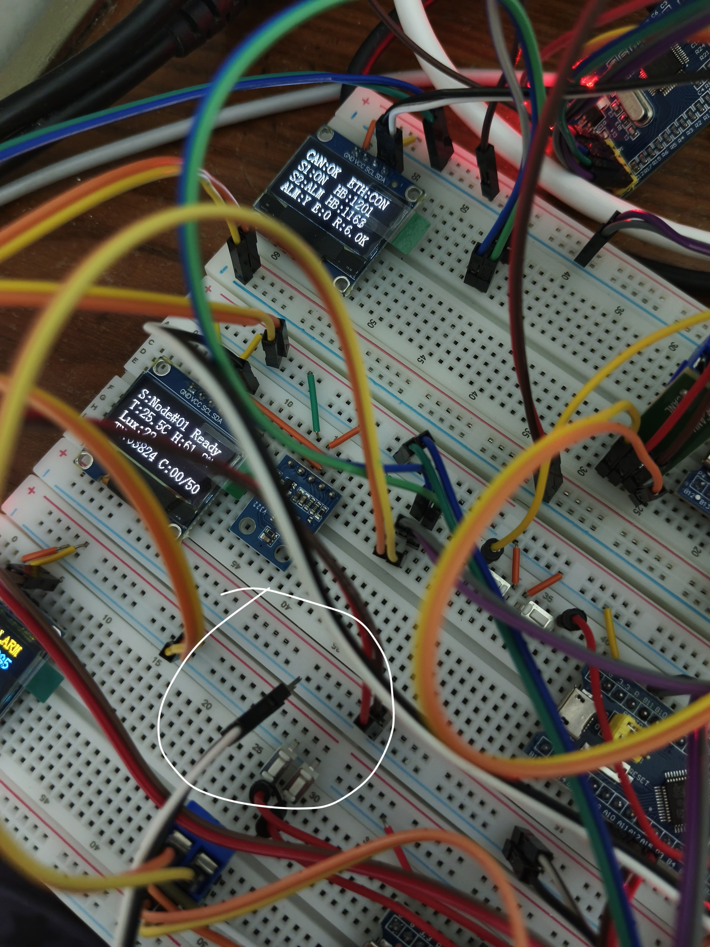
demo-phase3/主站检测-alm-从站2传感器掉线.jpg
