randomlyiii/Project_CAN-BusEdgeCollector/demo-phase3/主站检测-exp-从站2掉线.jpg

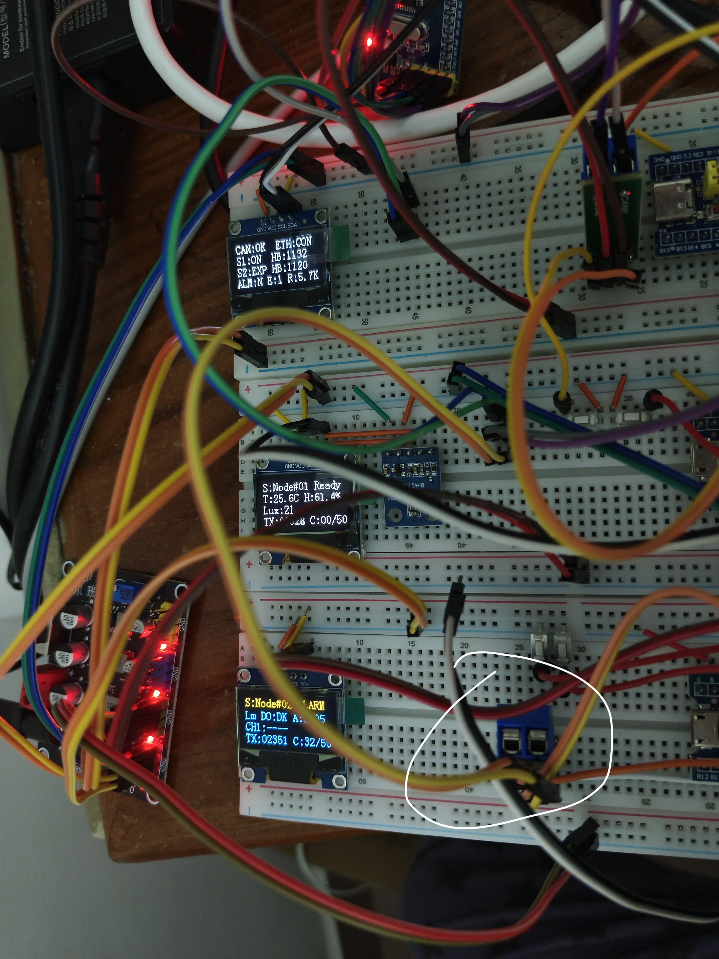
demo-phase3/主站检测-exp-从站2掉线.jpg
