randomlyiii/Project_CAN-BusEdgeCollector/demo-phase3/主站检测-所有从站修复完毕-主站正常运行图.jpg

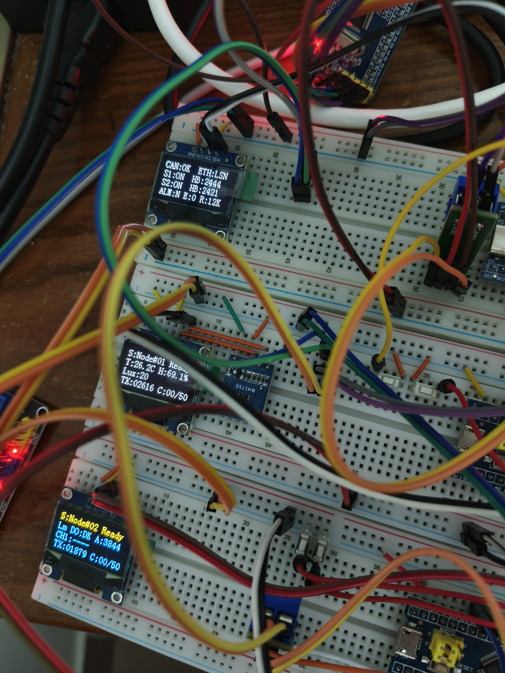
demo-phase3/主站检测-所有从站修复完毕-主站正常运行图.jpg
