randomlyiii/Project_CAN-BusEdgeCollector/demo-phase3/压力测试1-测试站3900帧每秒-暴力发帧-从站2正常运行.jpg

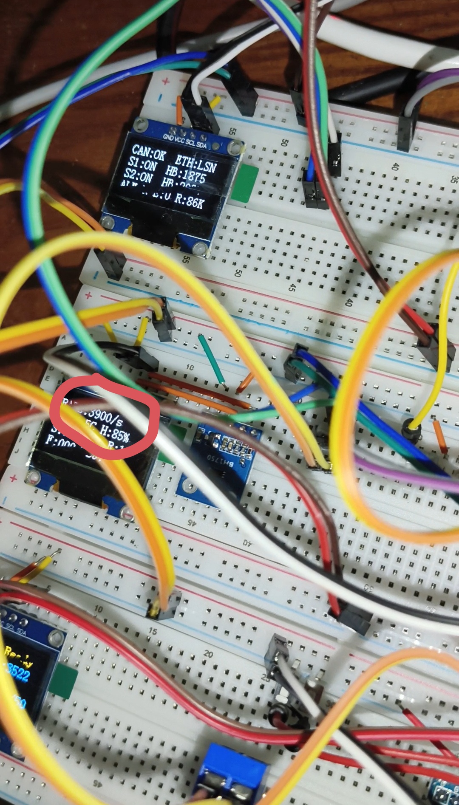
demo-phase3/压力测试1-测试站3900帧每秒-暴力发帧-从站2正常运行.jpg
