randomlyiii/Project_CAN-BusEdgeCollector/demo-phase3/压力测试2-2-测试站3900帧每秒-暴力发帧-主站显示-从站2正常告警恢复.jpg

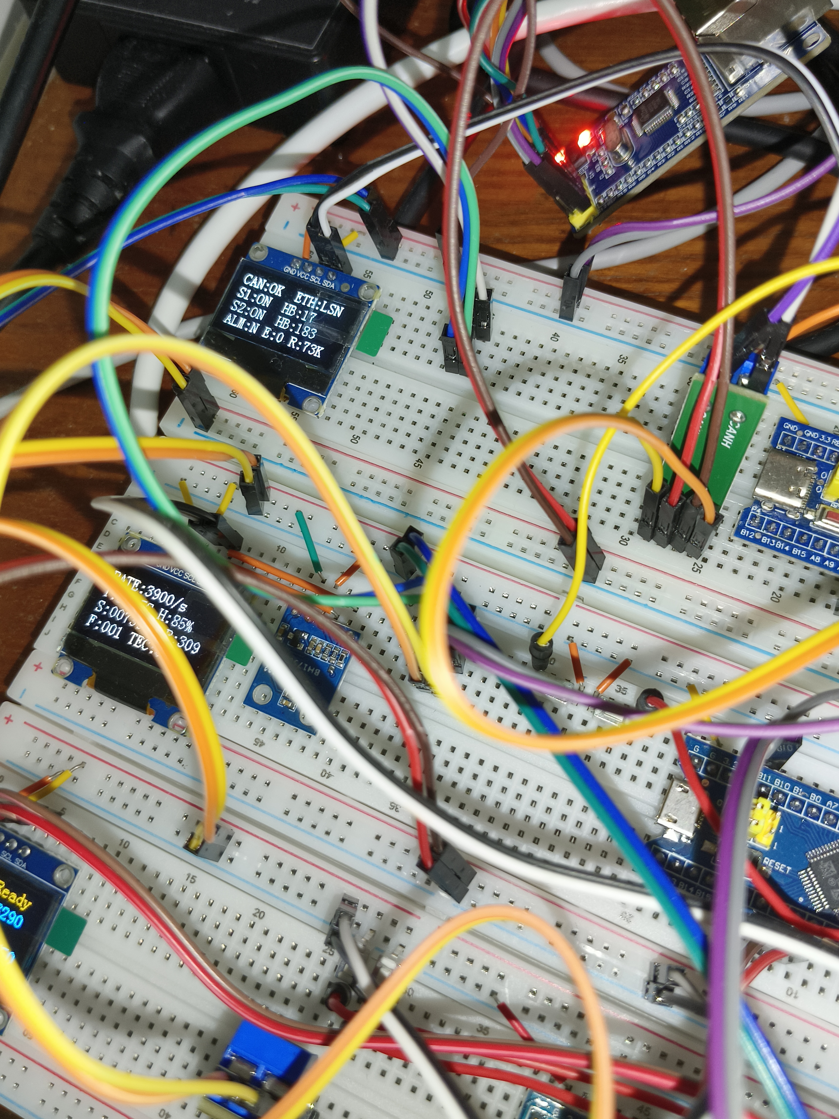
demo-phase3/压力测试2-2-测试站3900帧每秒-暴力发帧-主站显示-从站2正常告警恢复.jpg
