randomlyiii/Project_CAN-BusEdgeCollector/demo-phase3/硬件全览图.jpg

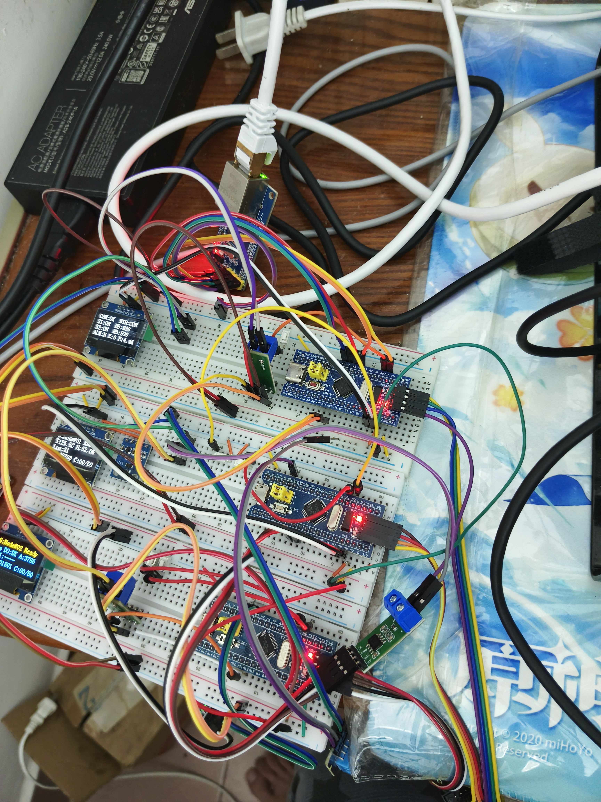
demo-phase3/硬件全览图.jpg
