randomlyiii/Project_CAN-BusEdgeCollector/demo-phase1/从站故障报警-oled第四行显示alm.jpg

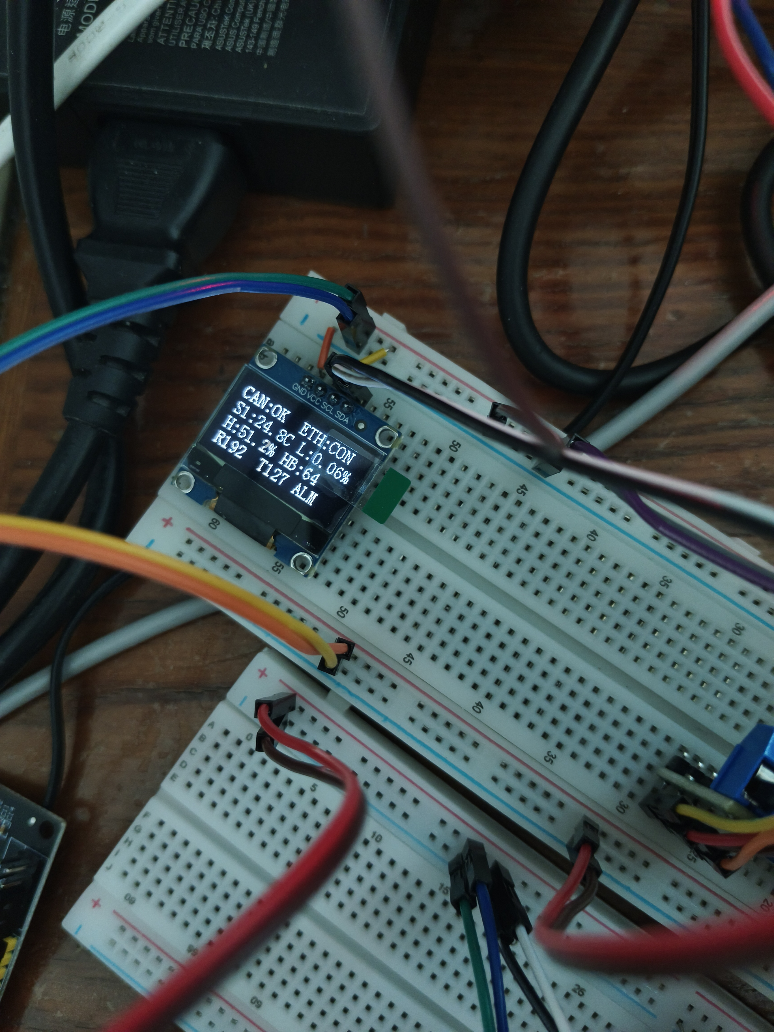
demo-phase1/从站故障报警-oled第四行显示alm.jpg
