randomlyiii/Project_CAN-BusEdgeCollector/demo-phase2/can总线故障-从站本地缓存+主站报警.jpg

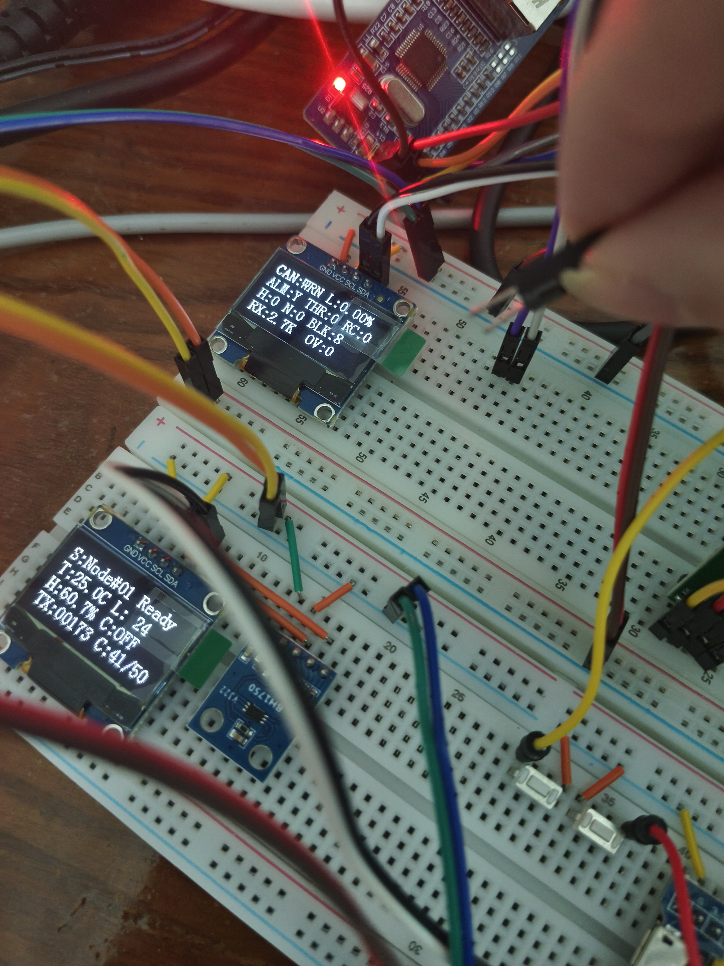
demo-phase2/can总线故障-从站本地缓存+主站报警.jpg
