randomlyiii/Project_CAN-BusEdgeCollector/(commit log)

2026-06-20 Initial commit: CAN Bus Edge Collector project (Master + Slave)
2026-07-23 阶段一：STM32 CAN通信 + 主站上位机交互 + OLED功能验证
    实现内容:
    1. Master STM32 CAN初始化/发送/接收/错误监控 (CAN_User.c/h)
    2. Slave STM32 CAN初始化/发送心跳/温湿度/报警/恢复 (CAN_User.c/h)
    3. Master W5500以太网驱动 + TCP Server模式 (W5500.c/h)
    4. Master Modbus TCP协议处理 (0x03读/0x06写) (ModbusTCP.c/h)
    5. Slave DHT11温湿度采集 + KEY1/KEY2按键检测 (KEY.c/h)
    6. SysTick 1ms滴答定时器 (Delay.c/h, 双工程同步更新)
    7. 主站OLED显示: CAN状态/温湿度/负载率/以太网连接
    8. 从站OLED显示: 节点ID/温湿度/CAN发送计数
    9. Keil项目文件更新 (uvprojx)
    10. 阶段一设计文档 + 排线图
    11. 硬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
2026-07-24 fix: 修复从站外设驱动 — DHT11卡死/超时, 按键极性, OLED I2C时序, SysTick中断保护, CAN 500kbps
    [CAN_User.c, CAN_User.h, KEY.c, KEY.h, OLED.c, dht11.c]
2026-07-24 feat: W5500以太网驱动完成 — RST=PC15, MISO=AF_PP, SPI帧格式[AddrH][AddrL][Ctrl]; ModbusTCP 0x03/0x06+寄存器映射; CAN ISR直接处理+错误监控
2026-07-24 feat: OLED 4×16新布局 — 温度+L负载(0.00%自适应精度), 湿度+心跳, R/T帧计数+状态(OK/ALM/BLK/OFF); bus_load升级0~10000; 黑名单放行ALARM/HEARTBEAT; Modbus响应偏移修正
    [main.c]
2026-07-24 docs: 阶段一验收文档+排线设计完善 — GND共地规范, W5500双GND+独立供电, ST-Link三线禁3.3V, 24条踩坑问题记录, 验收结果实测数据
2026-07-24 feat: 阶段二 FreeRTOS架构升级 — 工业级抗干扰数据采集终端
    核心变更:
    - FreeRTOS V10.4.6内核部署 (ARM Cortex-M3移植, heap_4)
    - 主站6任务: CAN_Rx(5) > CAN_Monitor(4) > CAN_Tx(3) > Protocol(2) > W5500(1) > Housekeep(0)
    - 从站4任务: Sensor(3) > CAN_Slave(2) > Key(1) > Housekeep(0)
    - 双FIFO缓冲: HIGH(16紧急帧) + NORMAL(64常规/低频帧), 互斥锁保护
    - 报文升降级: 传感器故障/CAN错误→0级升级, 500ms超时自动降级, KEY2手动降级
    - 总线负载自适应限流: <70%全量, 70-90%低频翻倍, ≥90%仅紧急+心跳(5%滞后防振荡)
    - CAN错误分级: 主动错误(日志) / 被动错误(限流) / BusOff(复位CAN+清FIFO+紧急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
2026-07-24 fix: FreeRTOS 工具链 — include 路径/configASSERT/DWT 延时/SysTick 全局时钟保护
    [dht11.c]
2026-07-24 fix: 内核结构体 — TCB_t 前向声明/完整结构统一/QueueDefinition 补全/StackMacros 标准实现
2026-07-24 fix: port.c ARMCC V5 移植 — __asm 函数直接命名 SVC_Handler/PendSV_Handler/SysTick 中转模式
2026-07-24 fix: tasks.c 调度核心 — 栈魔数填充/uxStackDepth/字比较/vTaskPlaceOnEventList 双重移除修复
2026-07-24 fix: CAN 运行时 — 中断使能与信号量创建顺序/FromISR 误用(任务上下文)/启动前信号量 Drain
    [CAN_User.c, CAN_User.h]
2026-07-24 fix: W5500 — 移除 taskENTER_CRITICAL(锁 SysTick)/SPI 缓存 W5500_IsLinkUpCached 防多任务抢占
    [W5500.c, W5500.h]
2026-07-24 fix: 主站 6 任务架构 — MSP 1024/Housekeep 栈 384/xTaskCreate 返回值检查/ETH_StateStr SPI 缓存/OLED 全面恢复
    [main.c]
2026-07-24 chore: 清理 — 移除外部 FreeRTOS 目录/bh1750 弃用驱动/更新 uvprojx 项目配置
2026-07-24 chore: .gitignore 排除硬件厂家资料目录
2026-07-28 fix: Master 统一顺序任务架构 + OLED 双页切屏
    [main.c]
2026-07-28 fix: CAN 配置修正 (波特率500kbps/PA11-IPU/ISR prio 5-6/IWDG 128-1250)
    [CAN_User.c, CAN_User.h]
2026-07-28 fix: Delay_GetTick 返回毫秒 (×portTICK_PERIOD_MS, 修复Master时间放大10x)
2026-07-28 fix: OLED 简化/W5500 缓存状态/ModbusTCP 小修
    [ModbusTCP.c, OLED.c, W5500.c]
2026-07-28 fix: FreeRTOSConfig 配置整理 + 从站 uvprojx 更新
2026-07-28 fix: Slave ARMCC __asm 直名 + tasks.c 栈填充/水位检测补丁
2026-07-28 fix: Slave 从站代码调整 (传感器/任务栈/OLED)
    [main.c]
2026-07-28 chore: .gitignore 排除厂家资料/调试目录 + README 文件分层标记
2026-07-28 docs: 阶段二文档归档 (设计/问题/FreeRTOS/OLED规范)
2026-07-28 feat: 阶段二验收截图 — 从站缓存/总线故障恢复/ModbusPoll 验证
2026-07-30 feat: 从站底层 — CAN零中断/ADC超时/本地缓存/MSP栈修复
    - CAN_User: 零中断纯轮询架构，移除 ISR/信号量/NVIC
    - lm393: ADC 校准/转换等待加超时保护
    - local_cache: 新增本地缓存补传机制
    - startup: MSP 栈 512→2048，防踩堆
    - ceg_slave.uvprojx: 工程配置同步
    [CAN_User.c, CAN_User.h, lm393.c, lm393.h, local_cache.c, local_cache.h]
2026-07-30 feat: 从站传感器抽象层 — Config + sensor_manager
    - Config/slave_config.h: 配置切换入口
    - Config/slave_node_01/02.h: 双从站变体配置
    - Config/sensor_type.h: 传感器类型枚举
    - sensor_manager: 表驱动 + 适配器模式 + 条件编译 + 故障累计告警
2026-07-30 feat: 从站任务重构 — ALARM 不限预算/Phase1+Phase2/启动错峰
    - ALARM/RECOVER 移出 tx_budget 控制: 紧急帧无条件发送
    - Phase1(传感器数据) + Phase2(告警/恢复) 分离: 掉线传感器也能发 ALARM
    - tx_budget 2→3: 心跳+数据+告警至少各1帧
    - 启动错峰: 按 node_id 延迟 0ms/2000ms
    - I2C 互斥锁接入 sensor_manager
2026-07-30 fix: 主站 W5500 SPI 超时保护
    - SPI 发送加 200 轮超时: 防止 CAN ALARM 帧电磁干扰 SPI 走线时 TXE 永远不置位
    - 超时后置 g_chip_ok=0: OLED 显示 ETH:FAIL，后续 SPI 操作跳过
    [W5500.c]
2026-07-30 feat: 主站 CAN 层重构 — 统一任务+INRQ恢复+心跳保护+FIFO启用
    架构变更:
    - 单任务统一架构: CAN Rx轮询 + 监控 + W5500 顺序执行
    - 全通滤波器 + FIFO0 Task轮询 (FMP0中断禁用)
    - 主站 receive-only: 不主动发帧, 防无ACK重传推TEC
    错误处理:
    - HeartBeatCheck: 加 error_level>=2 保护, BusOff 时不判假离线
    - CAN_ResetBus: DeInit+Init 改为 INRQ 协议恢复, 硬件走128隐性位
    - g_boff_consec: 边沿检测, 10ms周期内只累加一次
    FIFO:
    - CAN_ProcessFrame 恢复 FIFO_Push (按优先级分流)
    - 主站 receive-only 无自接收回环
    - SlaveNode_t: 增 lm393_analog/digital/reserved_ch1 字段
    - CAN_FUNC_LM393_DO/CAN_FUNC_RESER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
    [CAN_User.c, CAN_User.h]
2026-07-30 feat: 主站 Modbus 历史缓存 + FIFO drain + OLED 超时可调
    ModbusTCP:
    - 新增 Cache_Push: CAN帧→历史缓存, 环形缓冲100条
    - SyncFromCAN 尾端 FIFO drain: 紧急帧→HIGH, 常态帧→NORMAL
    - 断网恢复后批量上传复用现有机制
    - REG_OLED_AUTO_RETURN_MS 0x002C: 自动回主页超时可调
    主站 UI:
    - CAN_StateStr: 去 R 计数, 直接返回状态短串
    - 删未用变量 blk/frame
    - 删 PAGE_AUTO_RETURN_MS 宏, 改用 g_regs 寄存器读取
    - FIFO 寄存器 (0x0023-0x0026) 显示真实数据
2026-07-30 docs: 阶段三验收 + README + phase_md 文档归档
    - README.md: 全面更新 — Modbus TCP 寄存器操作表/功能实现状态(所属列)/10条设计决策/安全注意事项
    - can_standard_SPI.md: 更新 FIFO 启用/HeartBeatCheck BusOff保护/INRQ恢复
    - 最终阶段遇到的问题及解决.md: 新增问题十三(单节点假离线/ALARM/FIFO)
    - 最终阶段.md: 双从站复用架构文档定稿
    - 阶段最终问题.txt: 10个核心问题汇总
    - 阶段三验收截图: demo-phase3/ (主站 OLED + ModbusPoll + 硬件全览)
    - 阶段三排线设计: 排线设计文档定稿
2026-07-30 docs: 添加学习参考文档（脱敏版，供嵌入式练习参考）
    基于 README.md 与 phase_md 资料整理的学习交流版本。
    保留完整架构与业务流程，隐藏工业级深度容错核心方案，
    标注为进阶拓展方向供参考。
2026-07-30 fix: DLC/checksum校验 + 心跳隔离 + 告警限流
    - CAN_ProcessFrame: 清理DLC死代码, 加入checksum异或校验, 干扰帧丢弃
    - CAN_HeartBeatCheck: 去掉error_level>=2门禁, 节点独立判定
    - Master ALARM: 每节点200ms限频, 防告警风暴
    - Slave CAN_SendAlarm: 1s→连续5帧后降2s, g_alarm_drop_cnt丢弃计数
    [CAN_User.c, CAN_User.h]
2026-07-30 docs:文档更新
2026-08-03 feat:添加测试站文件
2026-08-04 feat: 测试站压测节拍回绕修复 + 负载折算公式注释
    - Run_Stress 节拍改相对差值, 修复 DWT CYCCNT 59.65s 回绕后死等 (~5万帧停发)
    - test_config.h 注释同步负载公式: 负载% = 帧率×122/500000×100% (主站 CFB=122)
    [main.c, test_config.h]
2026-08-04 feat: 主站CAN接收架构升级 ISR+紧凑ring64+独立drain任务 (300fps→总线满速零丢帧)
    - FMP0中断(RX0 ISR)把FIFO0帧搬入紧凑ring_high(12B×64), 替代10ms轮询(原300fps上限)
    - 修复F103 RX0向量名: USB_LP_CAN1_RX0_IRQHandler (md启动文件映射, CAN1_RX0会被linker删除致死循环)
    - 新增Task_CAN_Drain(prio3,10ms)独立消费ring, 解耦W5500阻塞(100~700ms)饿死CAN问题
    - g_can_ready门闸: CAN/FIFO初始化前drain任务只清ring不处理(防NULL mutex崩溃)
    - 负载折算CAN_FRAME_BITS 108→122(真实帧长), 修正低估真实总线占用
    - 页3清理调试T值, F:字段改为ring溢出指示
    [CAN_User.c, CAN_User.h, main.c]
2026-08-04 docs: 同步 ISR+ring64+drain 新架构到 can_standard_SPI/README/学习参考文档
    - can_standard_SPI: 主站3.1-3.4更新为三任务解耦+FMP0 ISR+紧凑帧, 3.6负载折算122位, 问题表加#14向量名/#15 W5500饿死/#16 300fps上限
    - README: 主站架构三任务图+接收链, 功能表加CAN高吞吐, 设计决策加#14-16
    - 学习参考文档: 主站架构改三任务协同(脱敏), 调试经验加RX0向量名陷阱
2026-08-04 feat: W5500 SPI异常自动恢复 — 快探重初始化+1s SIPR校验+恢复窗口4s→<1s
    缺口: 碰触W5500致SPI/电源引脚瞬时接触不良 → g_chip_ok=0 永久死, 需断电.
    修复:
    - W5500_Recovery(): 快探SPI(超时~2µs) → Init+ConfigNetwork+TCPServer_Start
    全量重初始化, 500ms节流. 死芯片期间每轮仅2µs, 负载度无影响
    - W5500_TCPServer_Run 顶部: g_chip_ok=0 转 Recovery, 不再永久死
    - 1s 周期 SIPR 校验: 抓电源抖动复位(SPI活但IP清零)假活场景
    - 恢复窗口: CLOSE_WAIT 1000→200ms, CLOSED 3000→500ms
    - .gitignore: 追加 build_out.txt
    [W5500.c, W5500.h]
2026-08-04 feat:压力测试验收
